Feinmechaniker/AVRCPM/README

Aeternum
CP/M - System auf Basis eines AVR

verwendetets System ZSDOS
