Feinmechaniker/AVRCPM/System/CPM/readme.txt

Terminaleinstellungen
-------------------------------
Terminaltype: VT100
Baudrate:	115200

Diskimage
--------------
A: CP/M Bootdisk + Tools
B: Turbo Pascal + I2C Tools
C: C-Compiler
D: ZSDOS Komplett
E: Wordstar
F: Turbo Pascal Installation
G: Quellen für ZSDOS System
