Feinmechaniker/AVRCPM/Case/Case.jpg

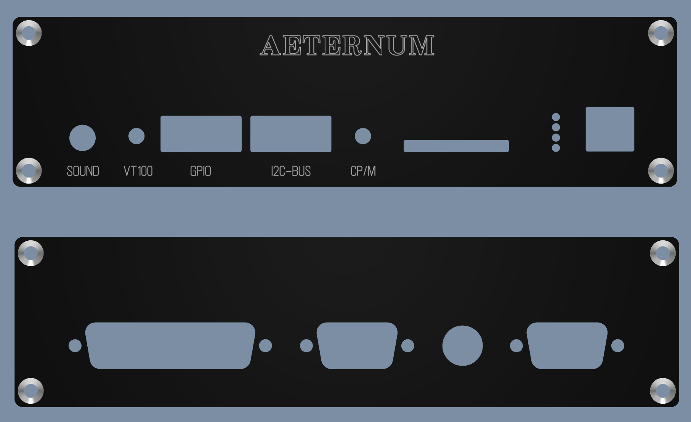
Case/Case.jpg
