Feinmechaniker/AVRCPM/Case/Hinten.dxf

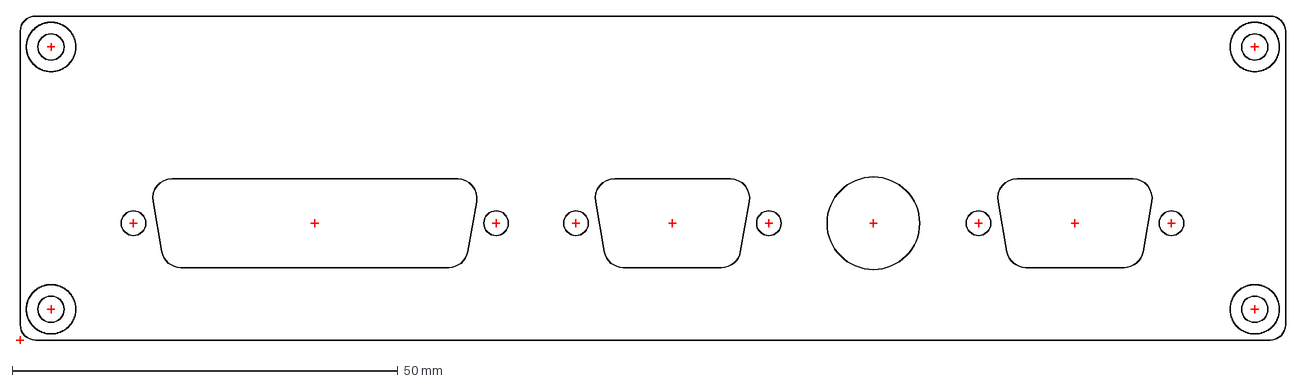
[picture p12: CAD file, 2019-03-15]
Case/Hinten.dxf
164.5 x 42.5 mm
