Feinmechaniker/AVRCPM/Case/Unten.dxf

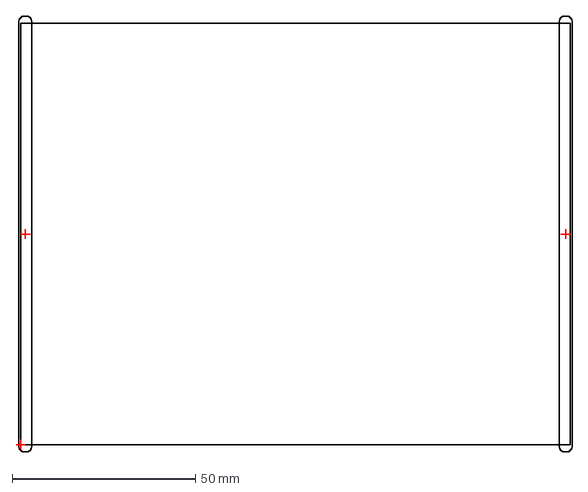
[picture p13: CAD file, 2019-03-07]
Case/Unten.dxf
151.8 x 119.0 mm
