Feinmechaniker/AVRCPM/Case/Oben.dxf

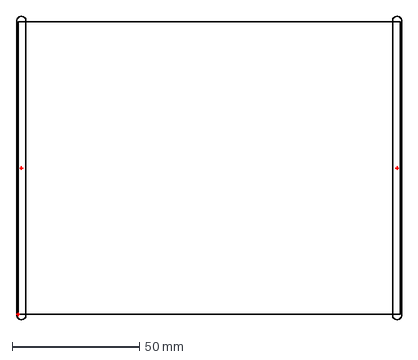
[picture p14: CAD file, 2019-03-07]
Case/Oben.dxf
151.2 x 119.0 mm
