Feinmechaniker/AVRCPM/(list of files, cad)

Other CAD files:
avr/avrcpm.obj
avr_7/avrcpm/default/avrcpm.obj
