Feinmechaniker/AVRCPM/Doku/Errata_V1_0.pdf

Errata Aeternum V1.x

Nr. | Inhalt | geändert | Vers.
1 Bestückungsdruck SW1 und SW2 ON/OFF vertauscht | DIP Switch richtig einbauen! | Board | 1.1
2 | Padgröße von C17 und C18 auf 0603 geändert | Board | 1.2
3 | Pad von C21 auf THT geändert und an IC U1 verlegt | Board | 1.2
4 | C12 von RTC an Vcc der RTC | Schaltung/Board | 1.3
5 | Q5 Package HC49U | Board | 1.3
6 | X2, X5 Befestigungspads mit Durchkontaktierung | Board | 1.3
