Feinmechaniker/AVRCPM/Doku/overview.pdf

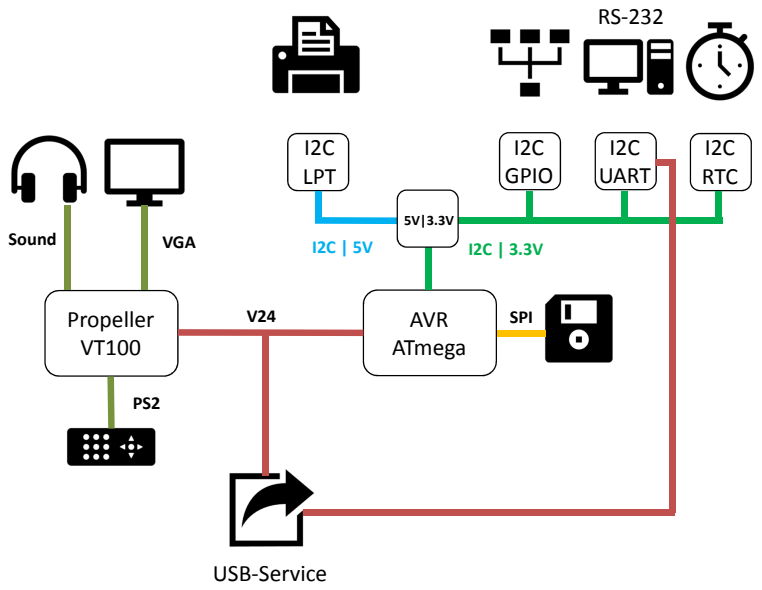
[picture p15: page 1]
Propeller VT100; USB-Service; AVR ATmega; I2C UART; I2C LPT; I2C RTC; I2C GPIO; SPI; Sound; VGA
