Feinmechaniker/AVRCPM/Sheet/Doc/Aeternum_V1_3_Sheet.pdf

8Q | 12 7Q | 13 6Q | 14 5Q | 15 4Q | 16 3Q | 17 2Q | 18 1Q | 19

A

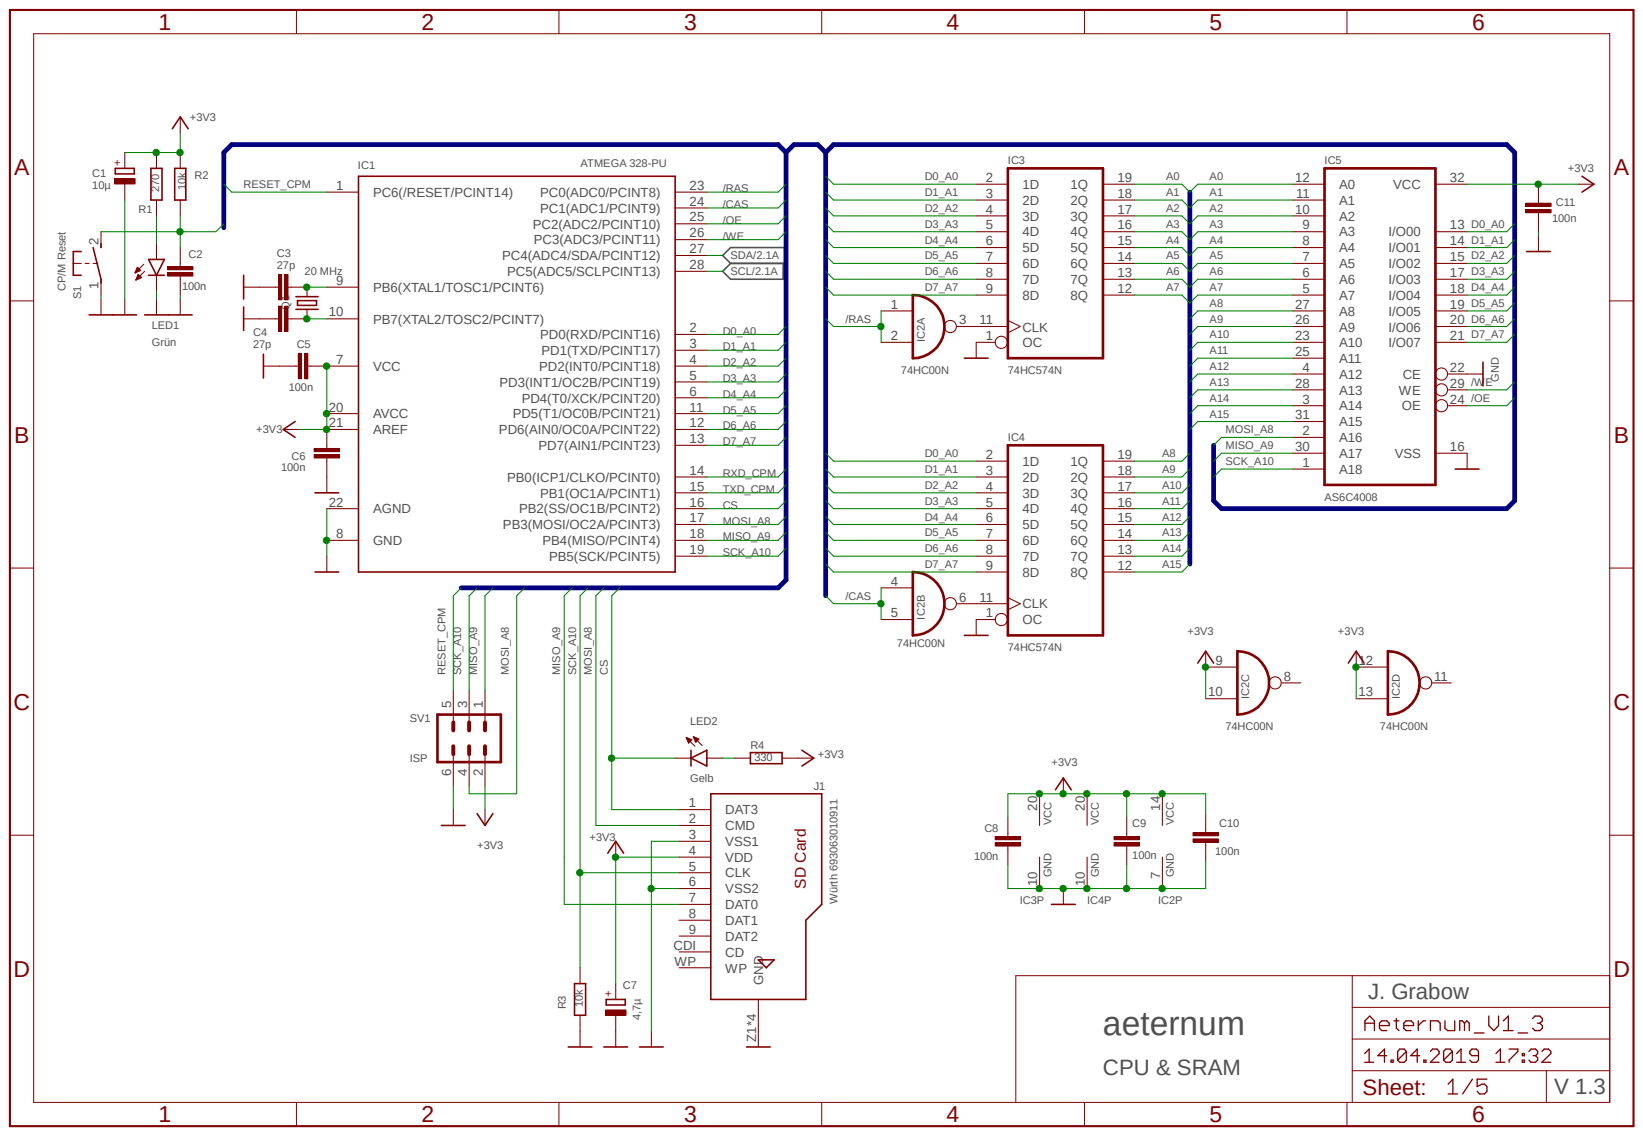
[picture p16: page 1]

A

A

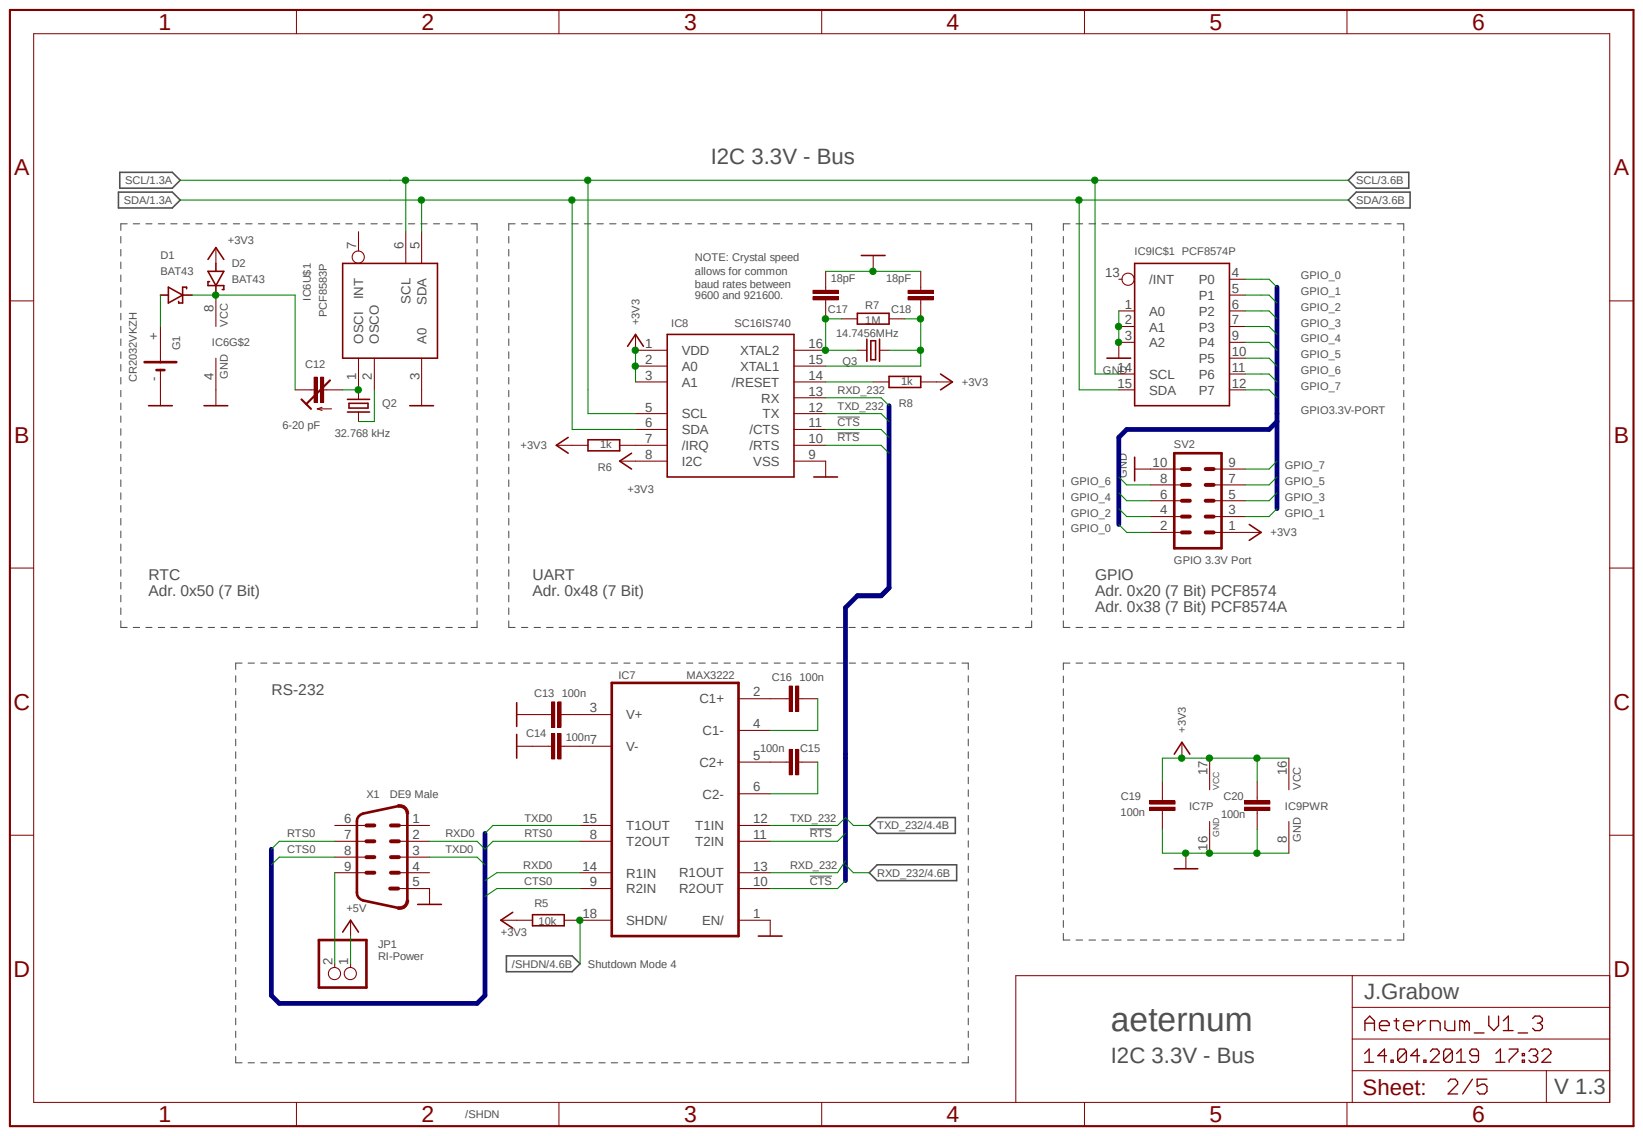
[picture p17: page 2]

I2C 3.3V - Bus

## CENTRONICS

A

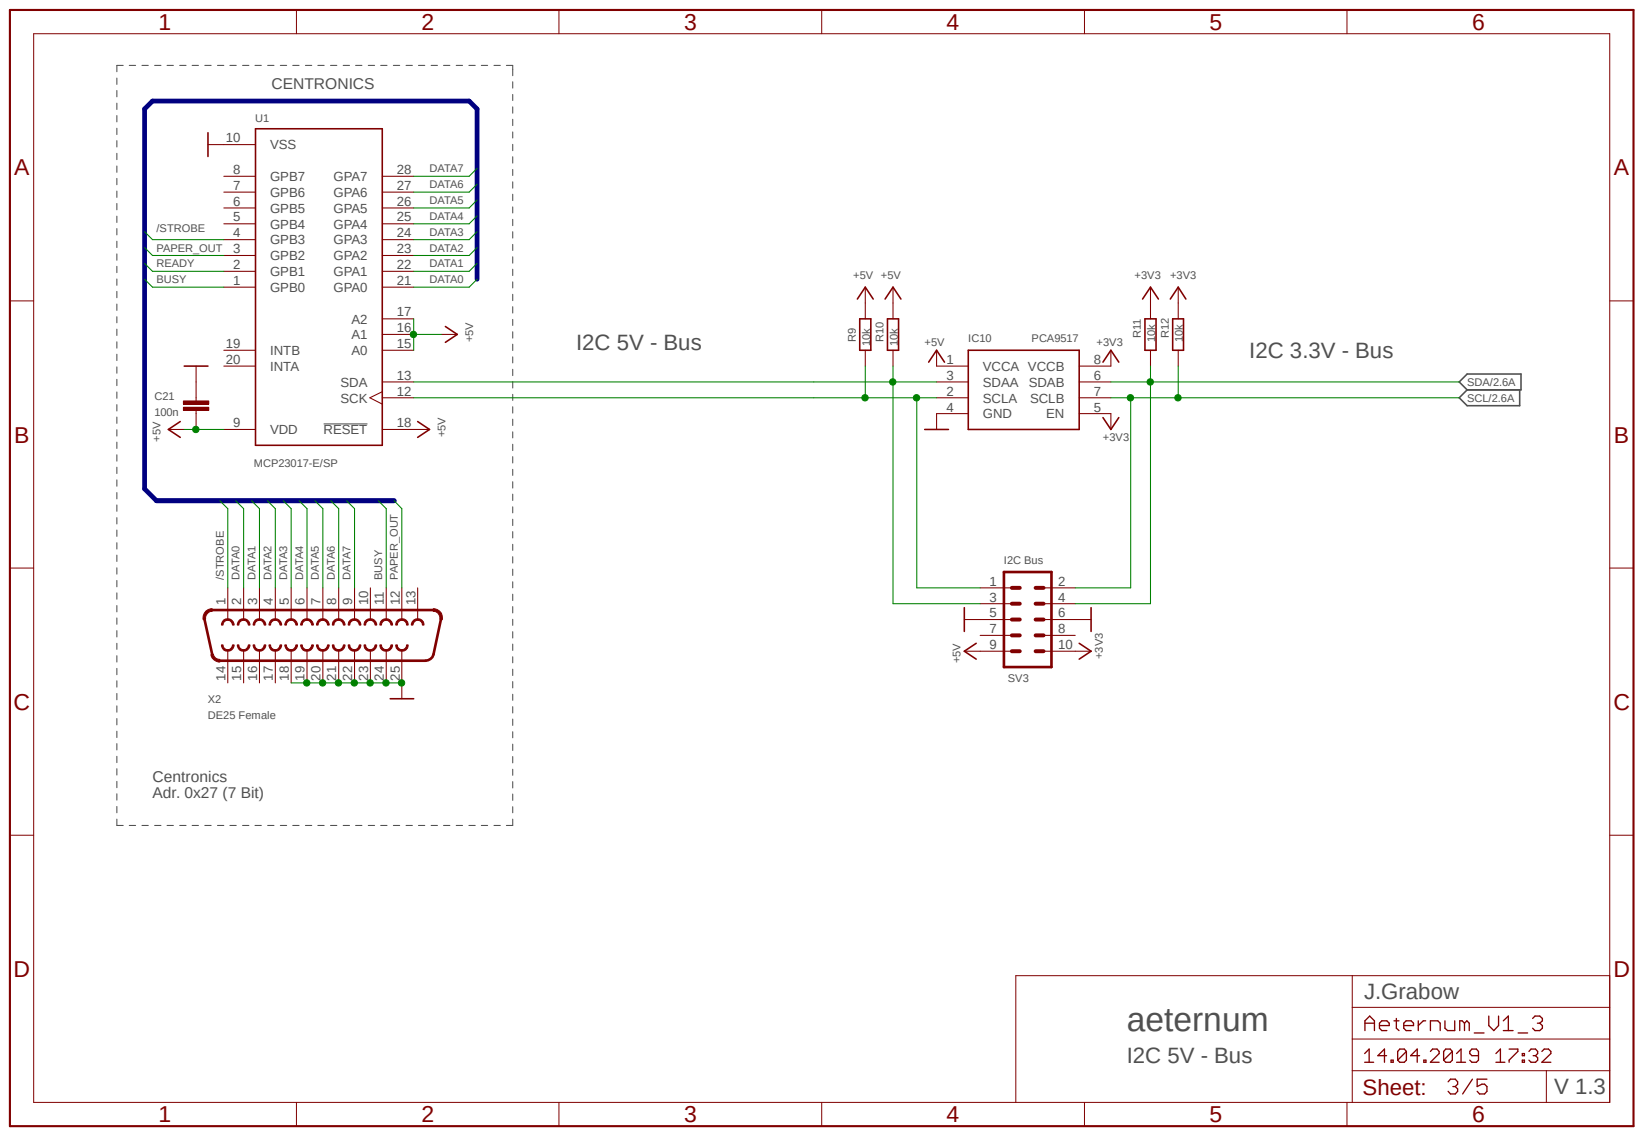
[picture p18: page 3]
I2C 5V - Bus; aeternum; J.Grabow; I2C 3.3V - Bus; Adr. 0x27 (7 Bit); Centronics; PCA9517; MCP23017-E/SP; DE25 Female; I2C Bus; SDAA 3 SCLA 2; VCCB; 8 VCCA 1; SDAB; SCLB; 5 GND 4; VDD 9; VSS 10; SCK; 12 SDA; RESET; INTA 20; INTB 19; GPA0; 21 GPA1; 22 GPA2; 23 GPA3; 24 GPA4; 25 GPA5; 26 GPA6; 27 GPA7; 28 GPB0 1; GPB1 2; GPB2 3; GPB3 4; GPB4 5; GPB5 6; GPB6 7; GPB7 8; SDA/2.6A SCL/2.6A; DATA0; DATA1; DATA2; DATA3; DATA4; DATA5; DATA6; DATA7; BUSY; READY; PAPER_OUT; /STROBE; Sheet:

A

A

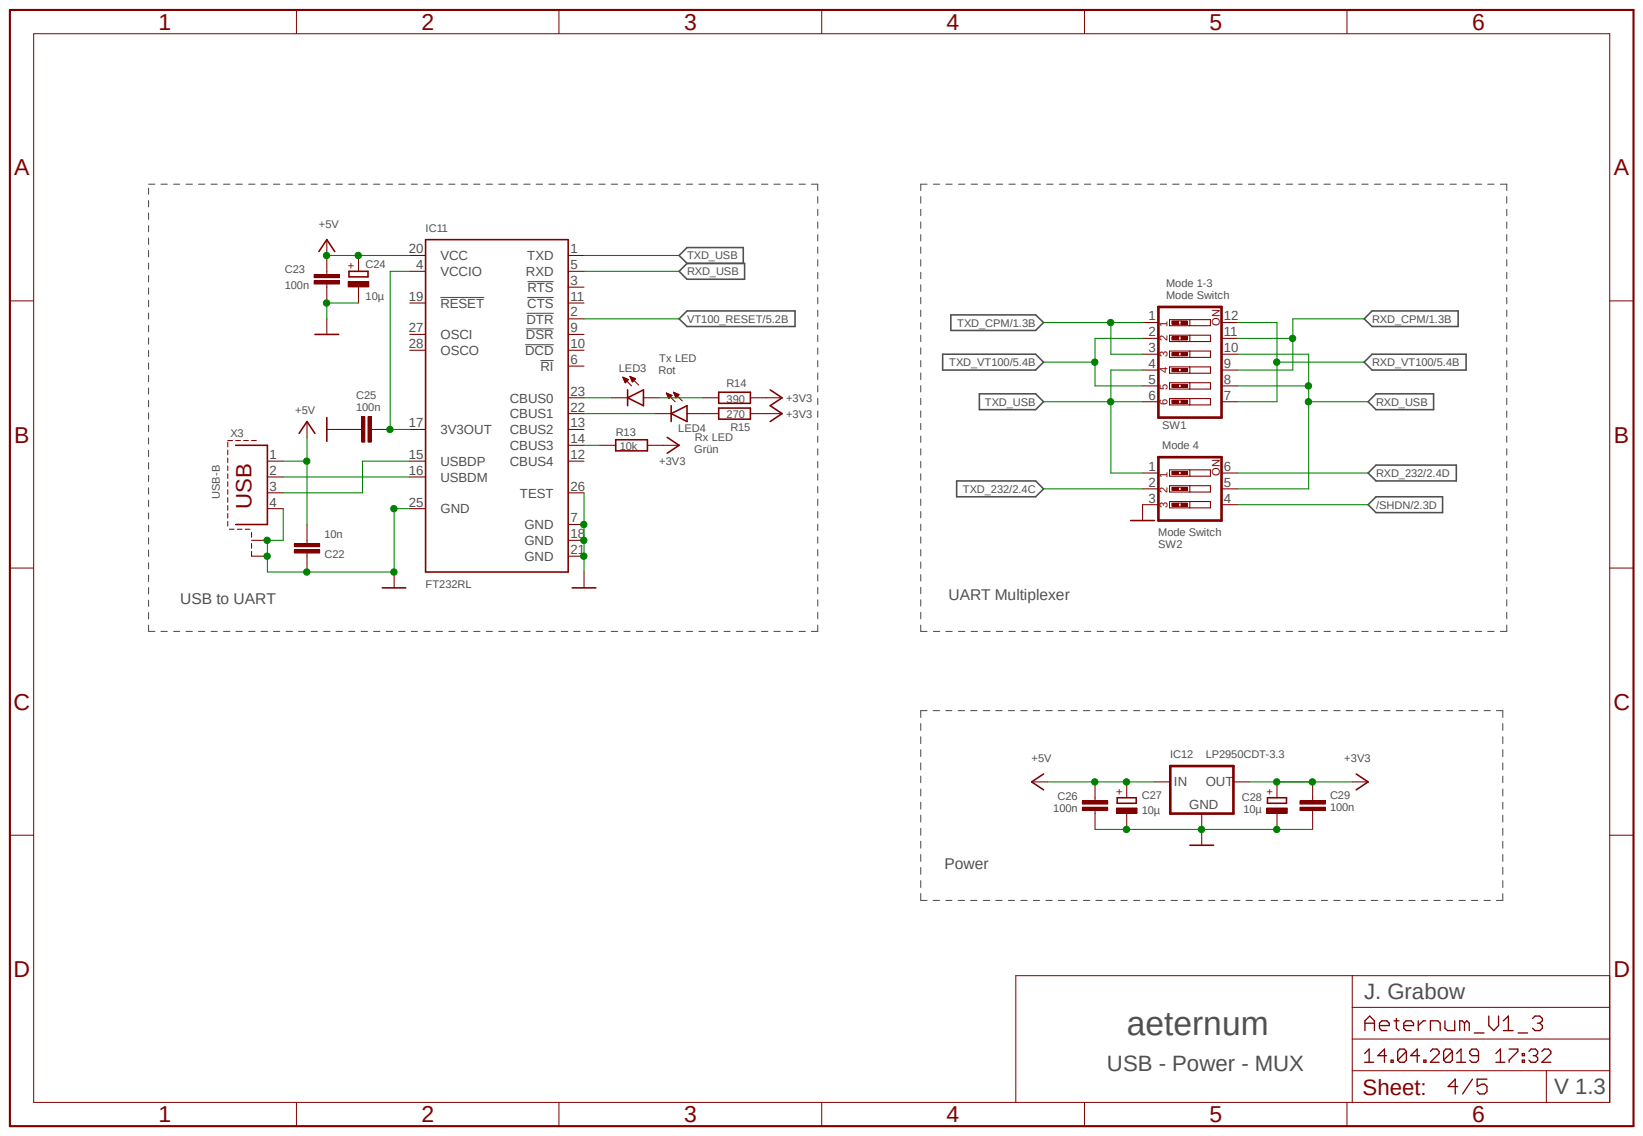
[picture p19: page 4]

A

A

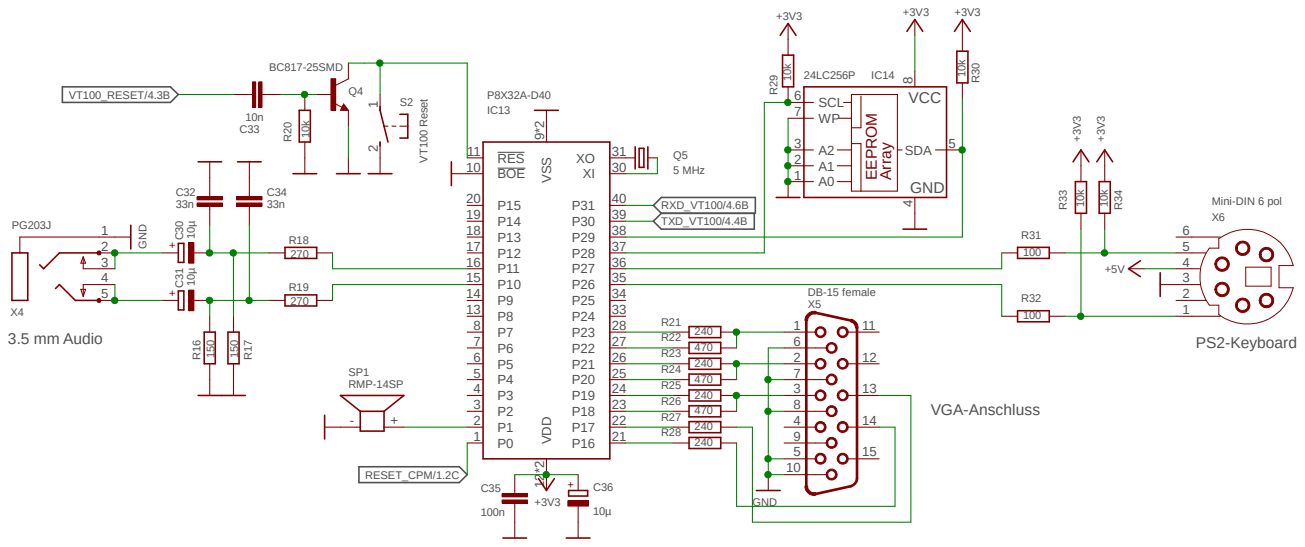
[picture p20: page 5]
