Feinmechaniker/AVRCPM/Case/Hinten.pdf

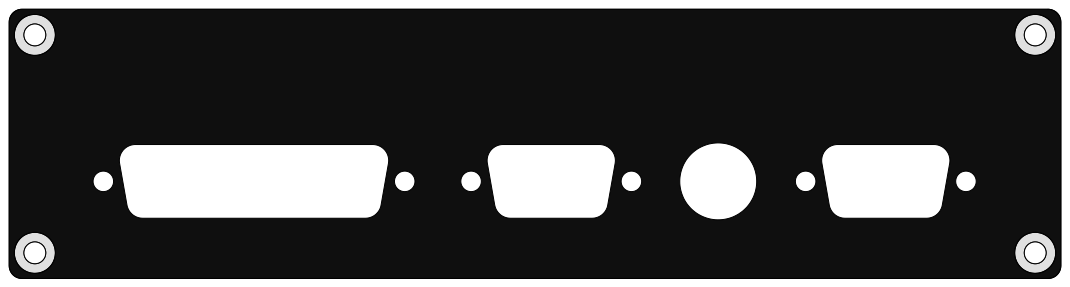
[picture p21: page 1]
