Feinmechaniker/AVRCPM/Sheet/Doc/Aeternum_V1_3_Bottom.pdf

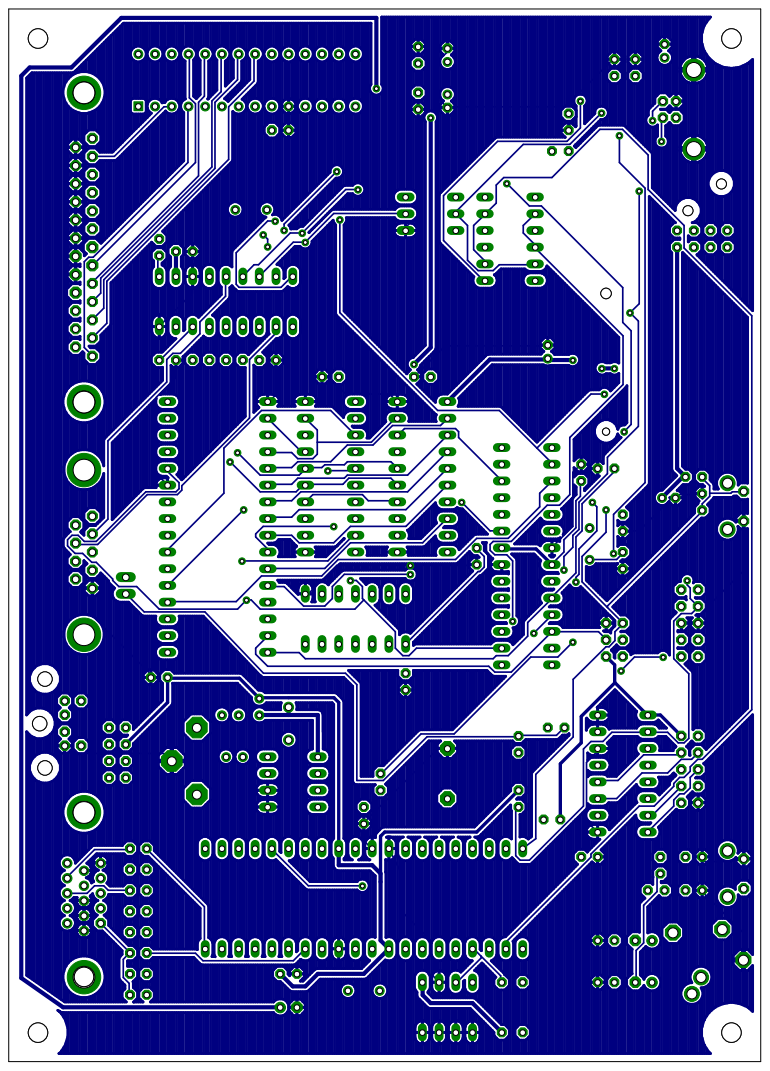
[picture p22: page 1]
