Feinmechaniker/AVRCPM/Sheet/Doc/Aeternum_V1_3_Doku.pdf

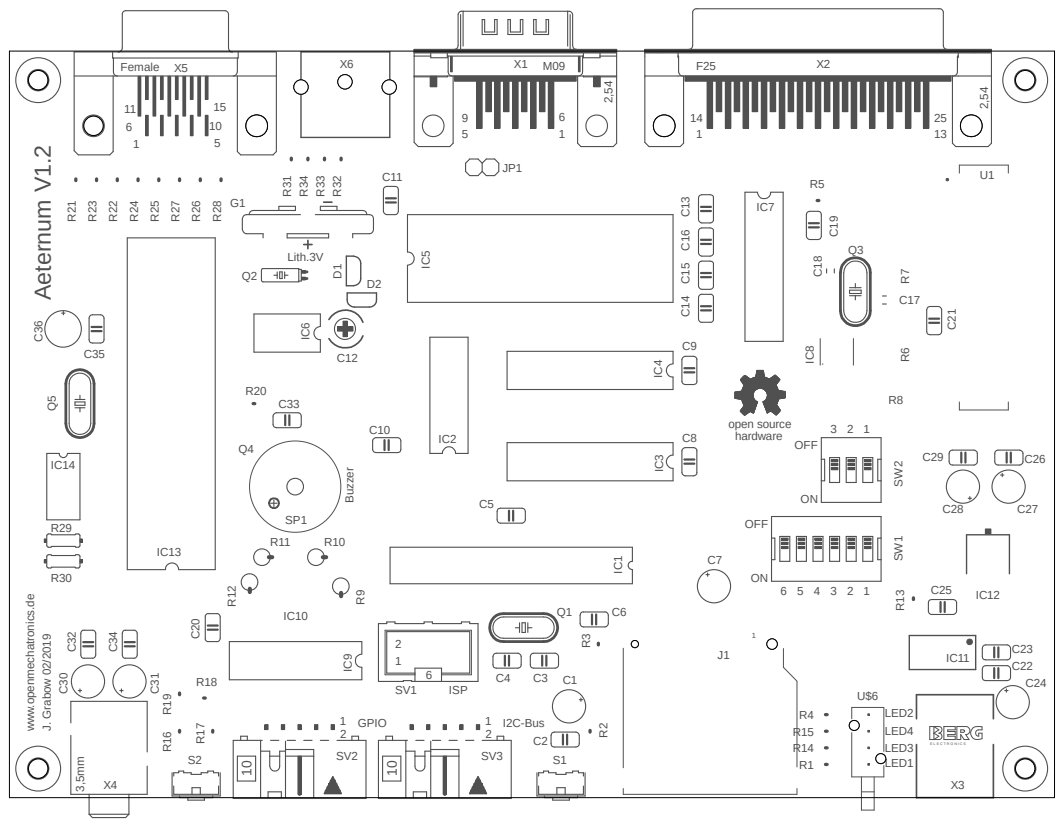
[picture p23: page 1]
