Feinmechaniker/AVRCPM/Sheet/Doc/Aeternum_V1_3_Top.pdf

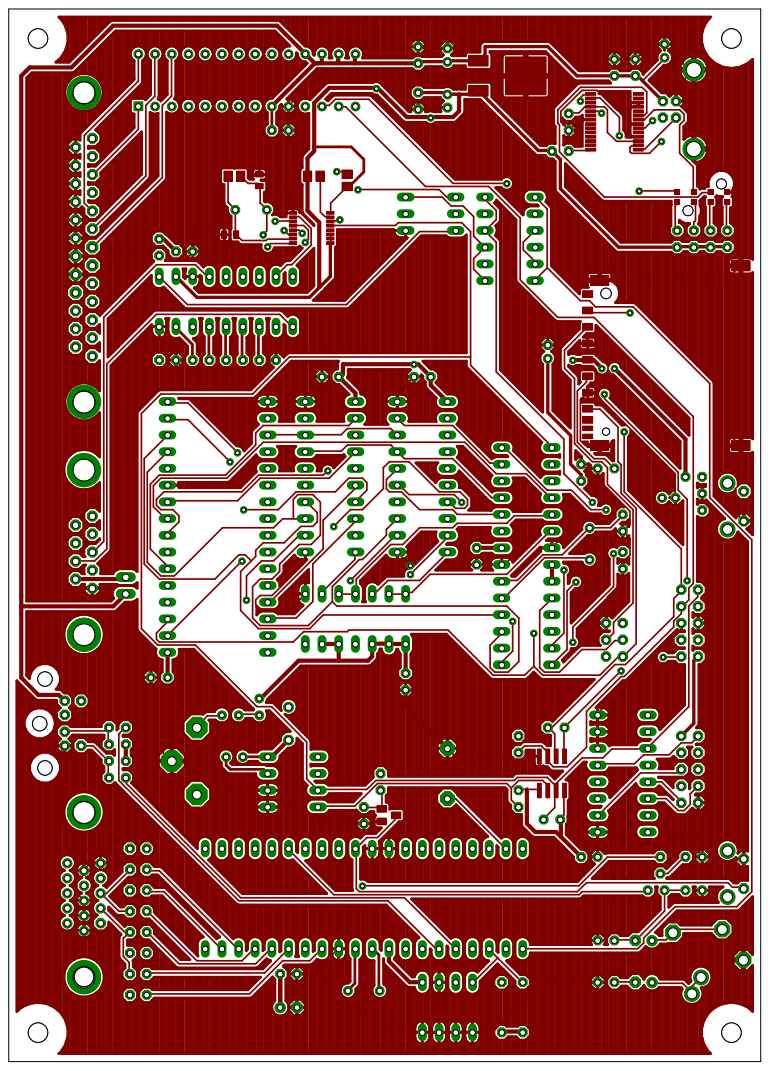
[picture p24: page 1]
