Feinmechaniker/AVRCPM/Sheet/Doc/Aeternum_V1_2_Dokupdf.pdf

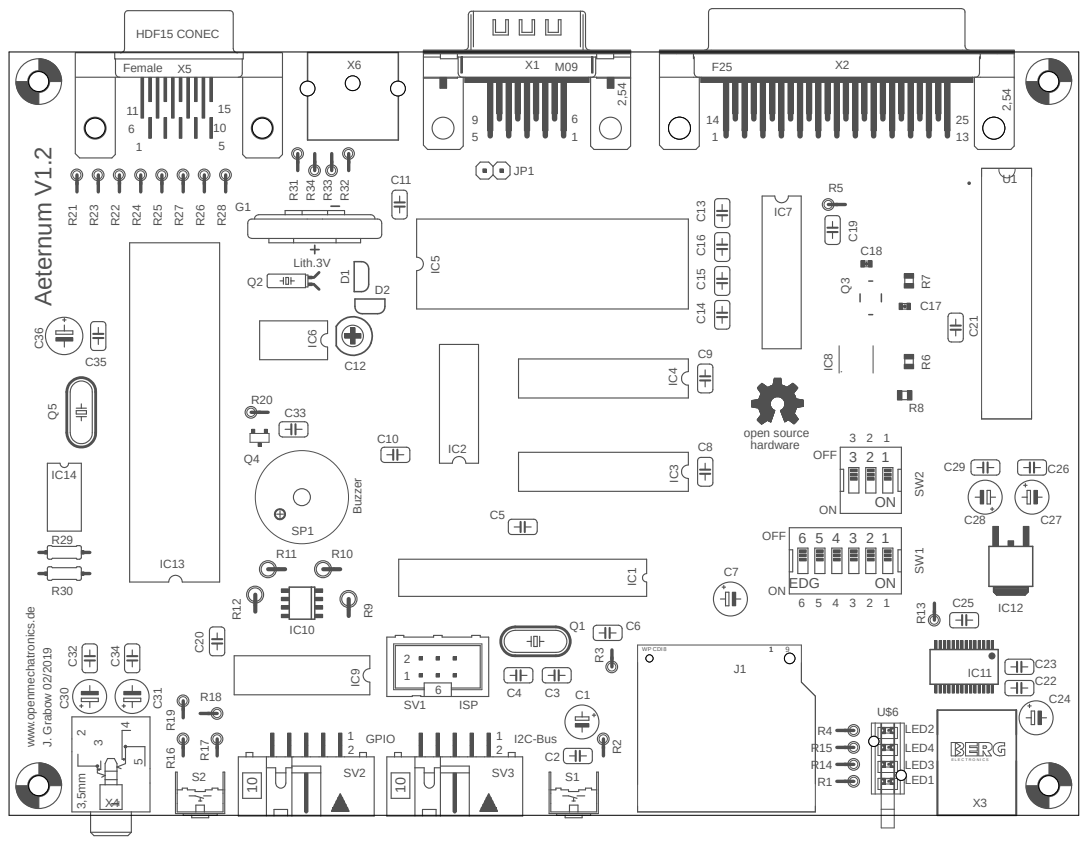
[picture p25: page 1]
