Feinmechaniker/AVRCPM/Sheet/Doc/Aeternum_V1_0_Bottom.pdf

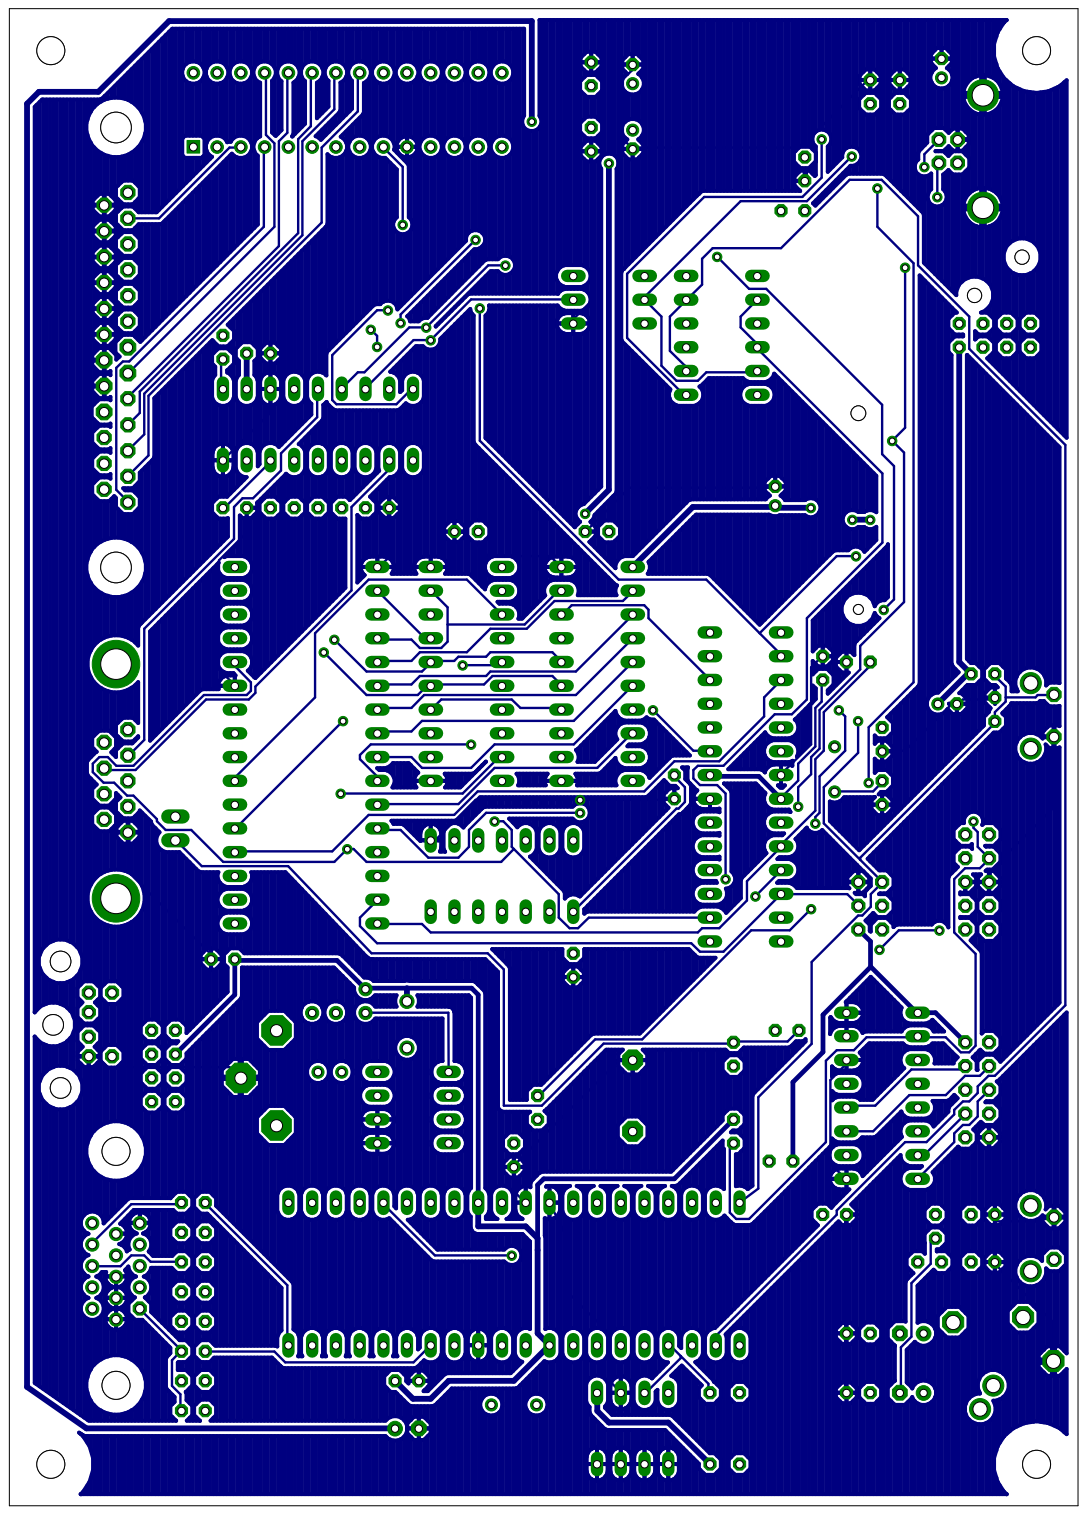
[picture p34: page 1]
