Feinmechaniker/AVRCPM/Sheet/Doc/Aeternum_V1_0_Doku.pdf

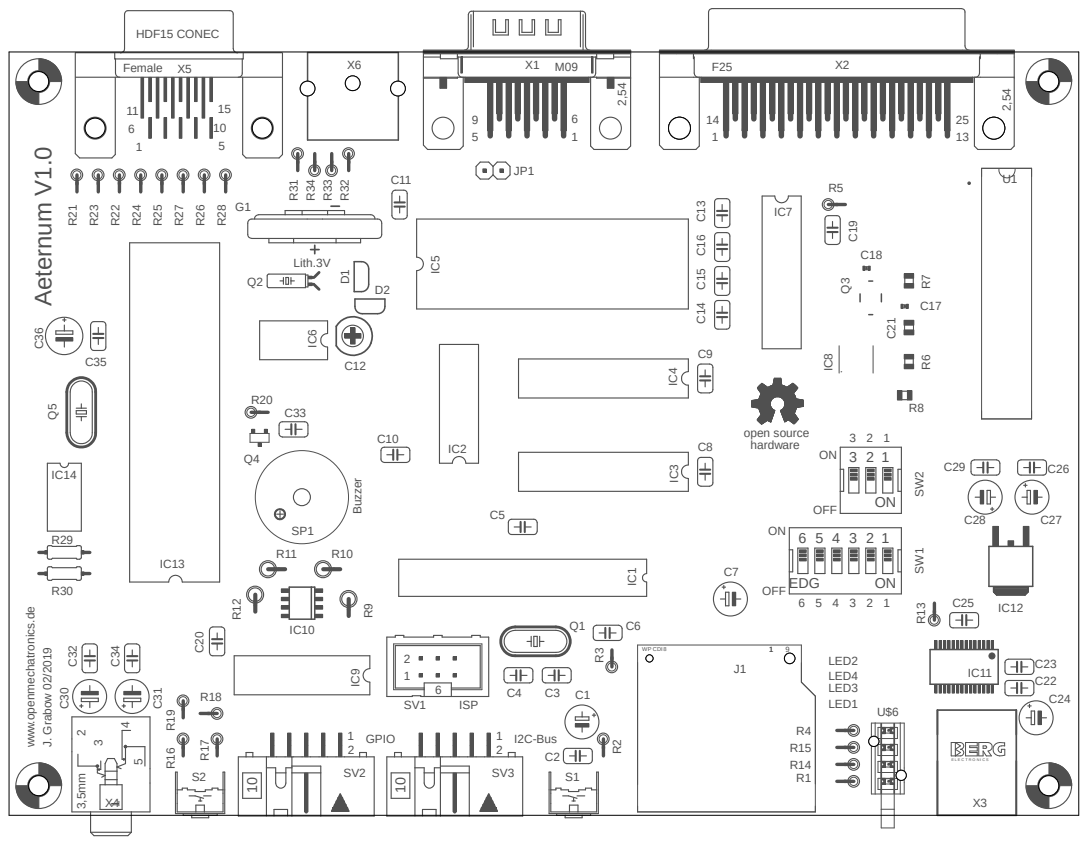
[picture p35: page 1]
