Feinmechaniker/AVRCPM/Sheet/Doc/Aeternum_V1_0_Top.pdf

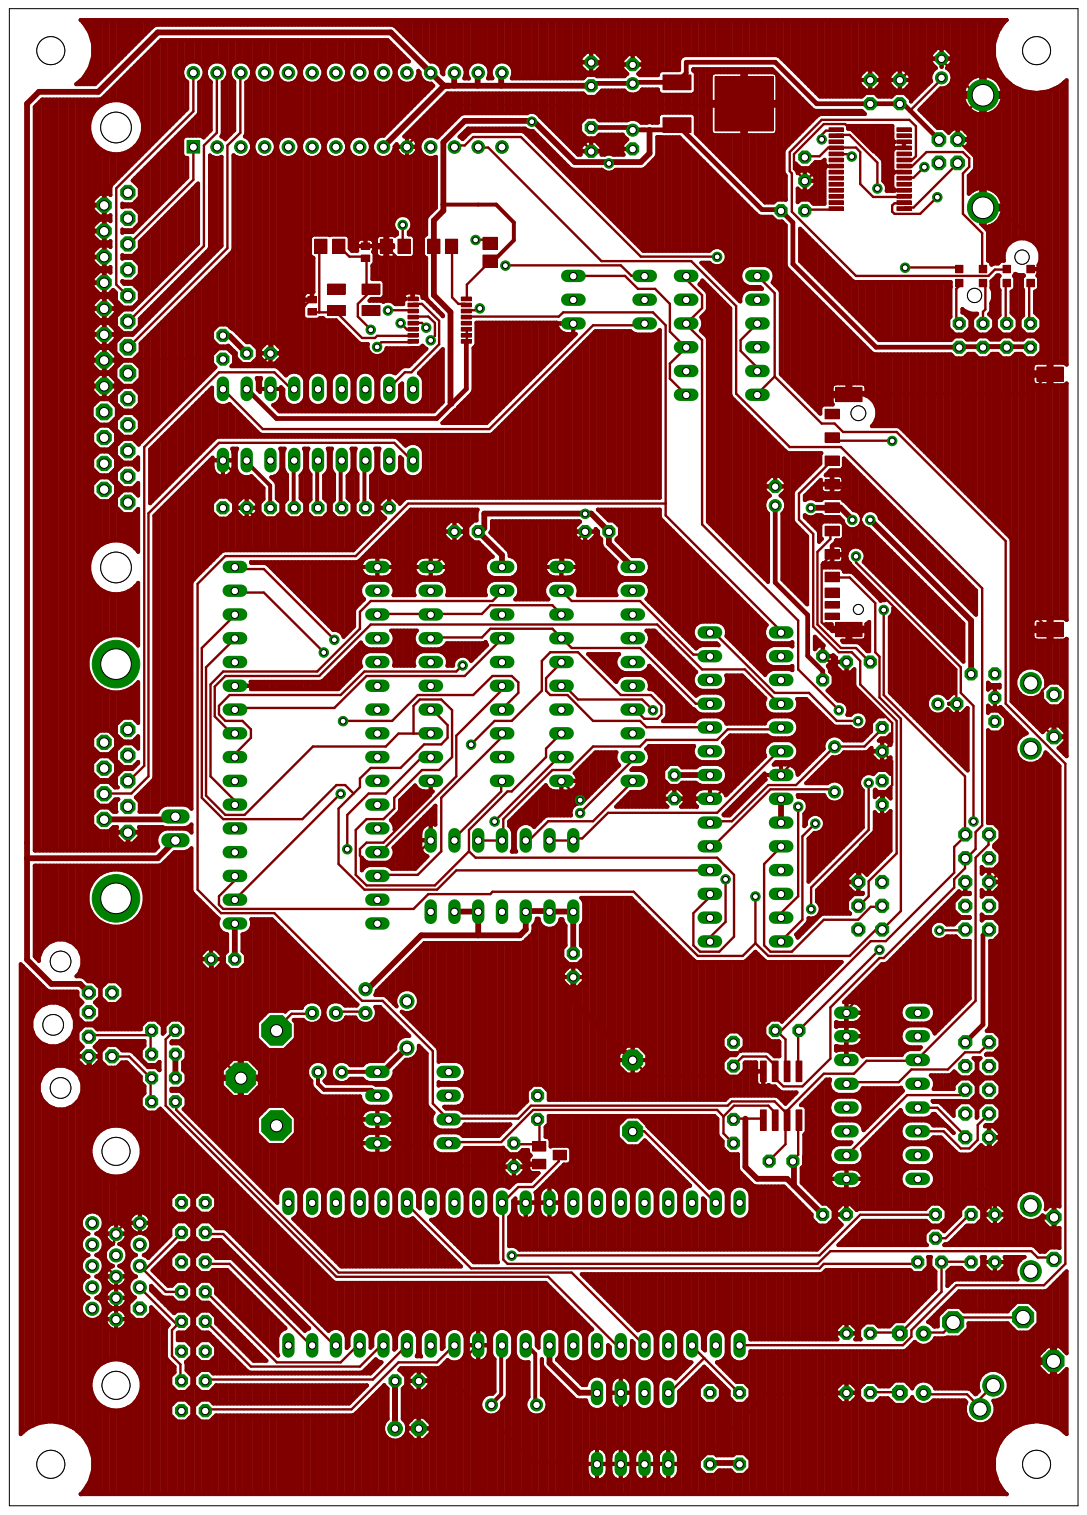
[picture p36: page 1]
