Feinmechaniker/AVRCPM/Sheet/Doc/Aeternum_V1_2_Bottom.pdf

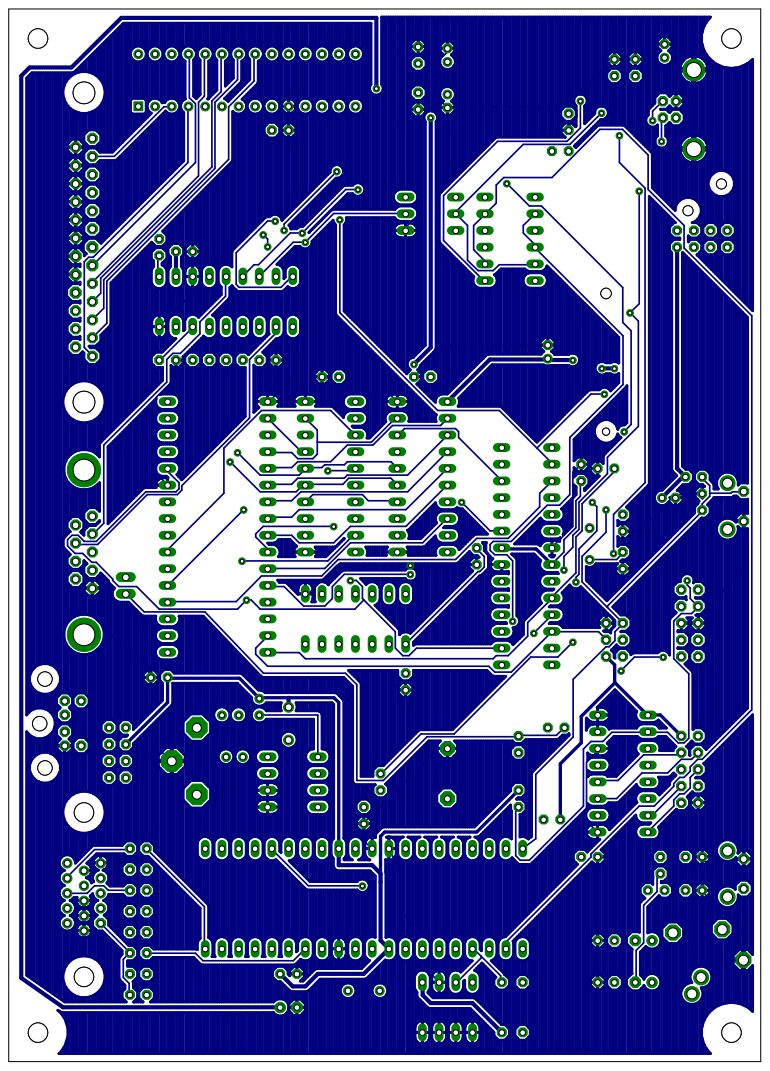
[picture p37: page 1]
