Feinmechaniker/AVRCPM/Sheet/Doc/Aeternum_V1_2_Top.pdf

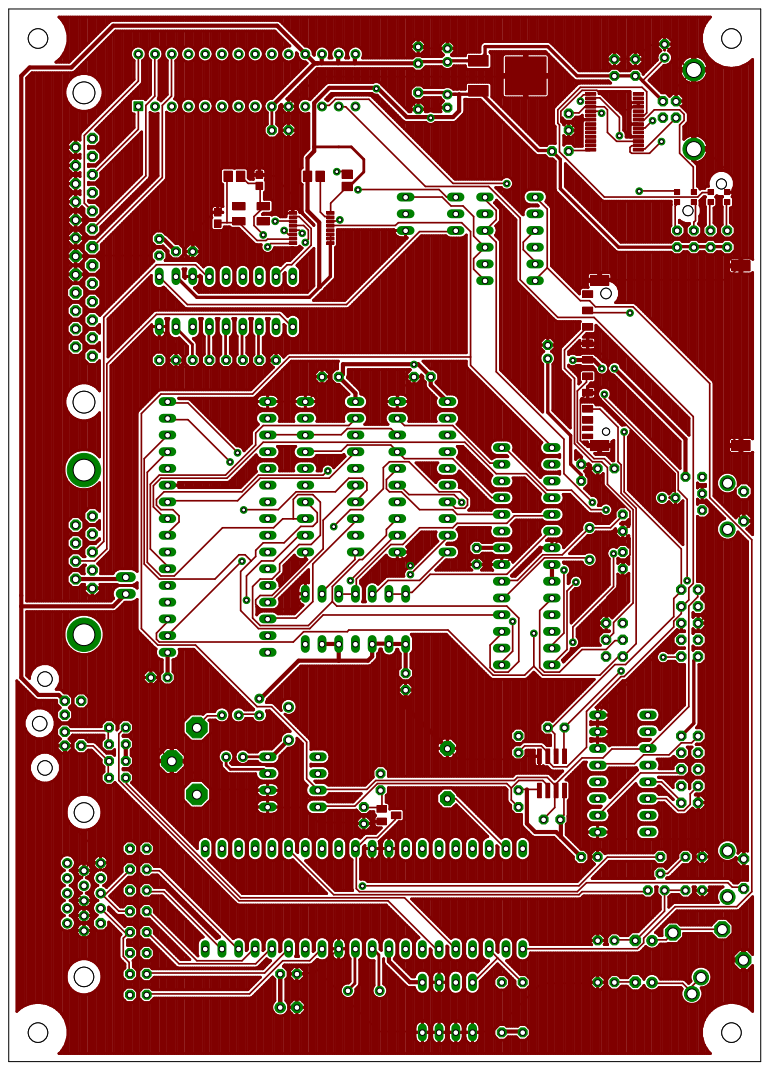
[picture p38: page 1]
