Feinmechaniker/AVRCPM/Sheet/Eagle/Aeternum_V1_2.brd

## EAGLE design Sheet/Eagle/Aeternum_V1_2.brd (2019-03-07)

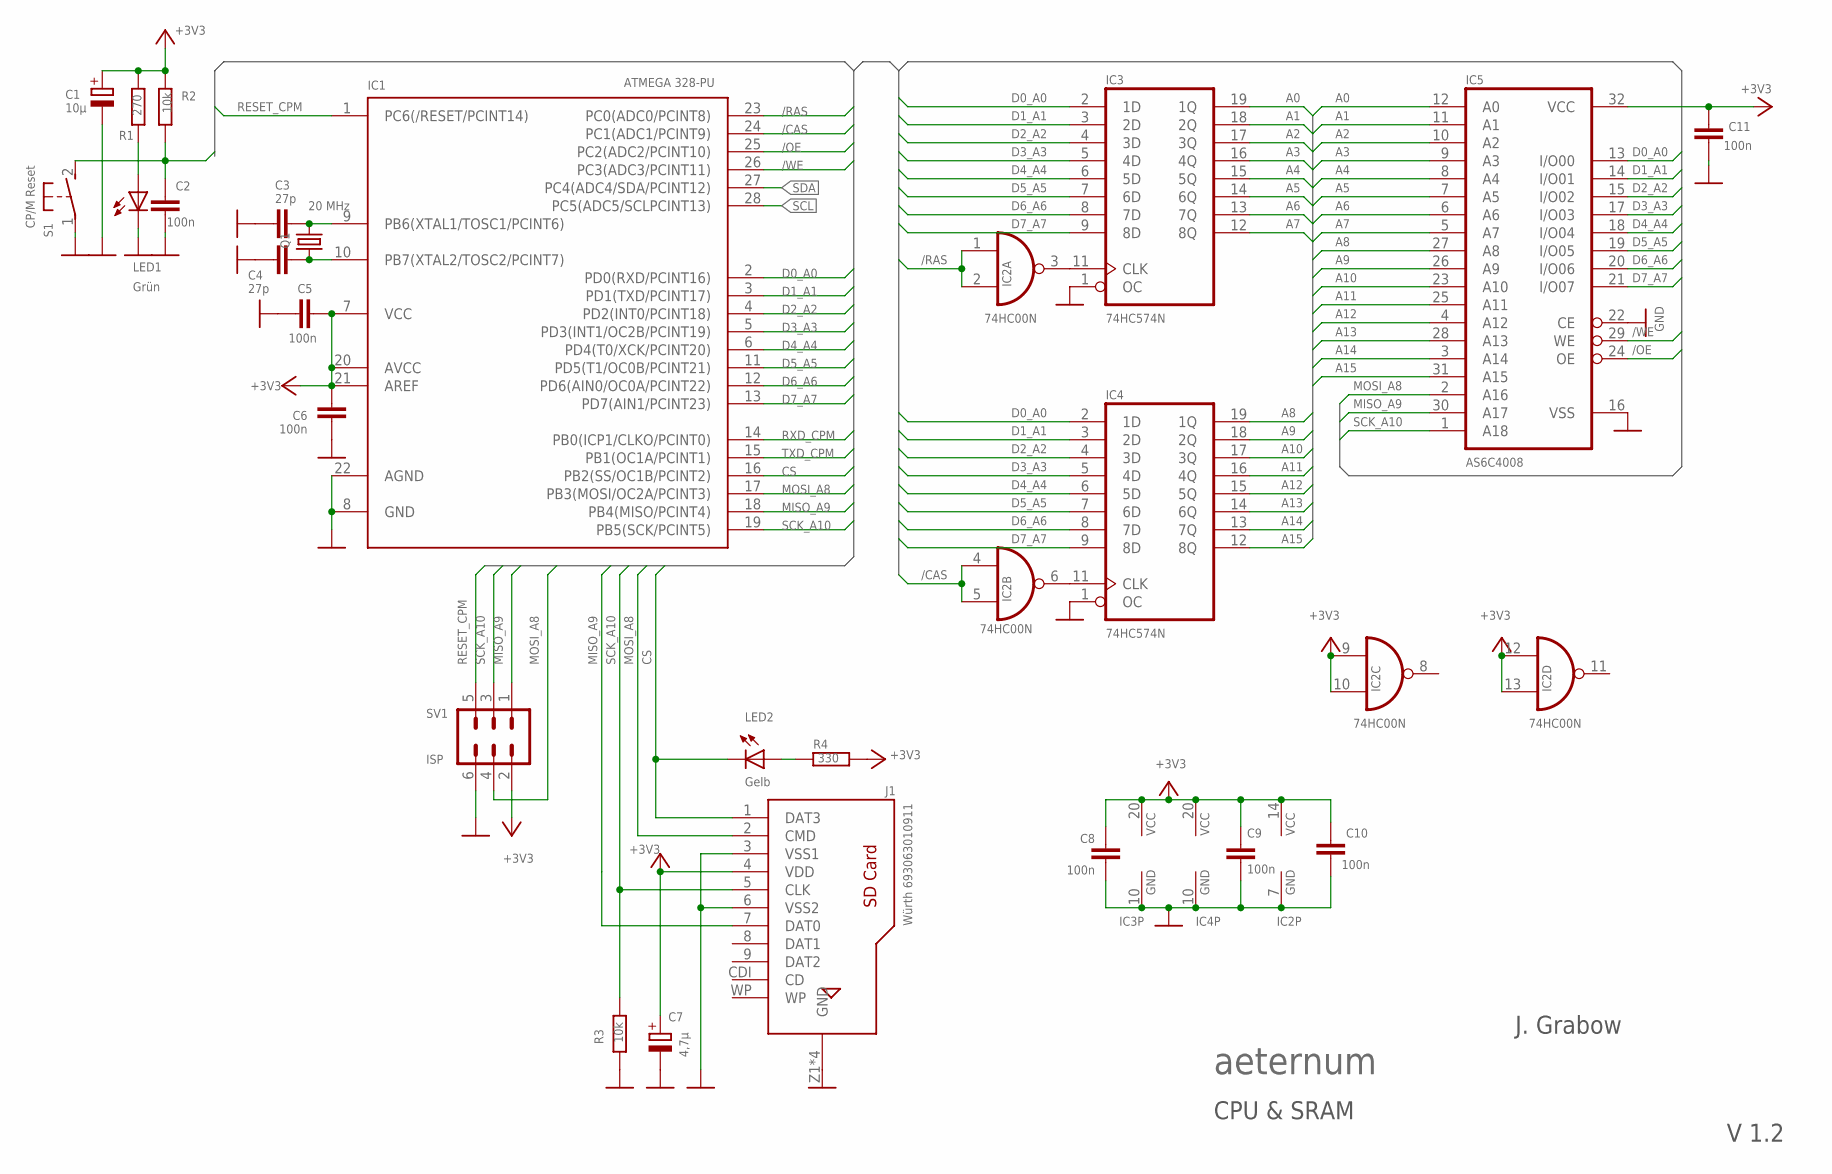
[picture p39: schematic Aeternum_V1_2.sch, sheet 1]

Parts:
C1: 10µ; E2-5
C2, C5, C6, C8, C9, C10, C11: 100n; C025-024X044
C3, C4: 27p; C025-024X044
C7: 4,7µ; E2-5
IC1: ATMEGA 328-PU; DIL28-3
IC2: 74HC00N; DIL14
IC3, IC4: 74HC574N; DIL20
IC5: AS6C4008; DIL32
J1: Würth 693063010911; 693063010911
LED1: Grün; CHIPLED_0603
LED2: Gelb; CHIPLED_0603
Q1: 20 MHz; HC49/S
R1: 270; 0204V
R2, R3: 10k; 0204V
R4: 330; 0204V
S1: CP/M Reset; B3F-31XX
SV1: ISP; ML6

Connections:
+3V3: C1.+, C5.1, C6.2, C7.+, C8.1, C9.1, C10.1, C11.1, IC1.7 (VCC), IC1.20 (AVCC), IC1.21 (AREF), IC2.9 (I0), IC2.10 (I1), IC2.12 (I0), IC2.13 (I1), IC2.14 (VCC), IC3.20 (VCC), IC4.20 (VCC), IC5.32 (VCC), J1.4 (VDD), R1.2, R2.1, R4.2, SV1.2; also elsewhere on the board
/CAS: IC1.24 (PC1(ADC1/PCINT9)), IC2.4 (I0), IC2.5 (I1)
/OE: IC1.25 (PC2(ADC2/PCINT10)), IC5.24 (OE)
/RAS: IC1.23 (PC0(ADC0/PCINT8)), IC2.1 (I0), IC2.2 (I1)
/WE: IC1.26 (PC3(ADC3/PCINT11)), IC5.29 (WE)
A0: IC3.19 (1Q), IC5.12 (A0)
A1: IC3.18 (2Q), IC5.11 (A1)
A2: IC3.17 (3Q), IC5.10 (A2)
A3: IC3.16 (4Q), IC5.9 (A3)
A4: IC3.15 (5Q), IC5.8 (A4)
A5: IC3.14 (6Q), IC5.7 (A5)
A6: IC3.13 (7Q), IC5.6 (A6)
A7: IC3.12 (8Q), IC5.5 (A7)
A8: IC4.19 (1Q), IC5.27 (A8)
A9: IC4.18 (2Q), IC5.26 (A9)
A10: IC4.17 (3Q), IC5.23 (A10)
A11: IC4.16 (4Q), IC5.25 (A11)
A12: IC4.15 (5Q), IC5.4 (A12)
A13: IC4.14 (6Q), IC5.28 (A13)
A14: IC4.13 (7Q), IC5.3 (A14)
A15: IC4.12 (8Q), IC5.31 (A15)
CS: IC1.16 (PB2(SS/OC1B/PCINT2)), J1.1 (DAT3), LED2.C
D0_A0: IC1.2 (PD0(RXD/PCINT16)), IC3.2 (1D), IC4.2 (1D), IC5.13 (I/O00)
D1_A1: IC1.3 (PD1(TXD/PCINT17)), IC3.3 (2D), IC4.3 (2D), IC5.14 (I/O01)
D2_A2: IC1.4 (PD2(INT0/PCINT18)), IC3.4 (3D), IC4.4 (3D), IC5.15 (I/O02)
D3_A3: IC1.5 (PD3(INT1/OC2B/PCINT19)), IC3.5 (4D), IC4.5 (4D), IC5.17 (I/O03)
D4_A4: IC1.6 (PD4(T0/XCK/PCINT20)), IC3.6 (5D), IC4.6 (5D), IC5.18 (I/O04)
D5_A5: IC1.11 (PD5(T1/OC0B/PCINT21)), IC3.7 (6D), IC4.7 (6D), IC5.19 (I/O05)
D6_A6: IC1.12 (PD6(AIN0/OC0A/PCINT22)), IC3.8 (7D), IC4.8 (7D), IC5.20 (I/O06)
D7_A7: IC1.13 (PD7(AIN1/PCINT23)), IC3.9 (8D), IC4.9 (8D), IC5.21 (I/O07)
GND: C1.-, C2.1, C3.2, C4.2, C5.2, C6.1, C7.-, C8.2, C9.2, C10.2, C11.2, IC1.8 (GND), IC1.22 (AGND), IC2.7 (GND), IC3.1 (OC), IC3.10 (GND), IC4.1 (OC), IC4.10 (GND), IC5.16 (VSS), IC5.22 (CE), J1.3 (VSS1), J1.6 (VSS2), J1.Z1 (GND), J1.Z2 (GND), J1.Z3 (GND), J1.Z4 (GND), LED1.C, R3.2, S1.1, SV1.6; also elsewhere on the board
MISO_A9: IC1.18 (PB4(MISO/PCINT4)), IC5.30 (A17), J1.7 (DAT0), SV1.1
MOSI_A8: IC1.17 (PB3(MOSI/OC2A/PCINT3)), IC5.2 (A16), J1.2 (CMD), SV1.4
unnamed: C4.1, IC1.10 (PB7(XTAL2/TOSC2/PCINT7)), Q1.1
unnamed: IC2.3 (O), IC3.11 (CLK)
unnamed: LED1.A, R1.1
unnamed: LED2.A, R4.1
unnamed: C3.1, IC1.9 (PB6(XTAL1/TOSC1/PCINT6)), Q1.2
unnamed: IC2.6 (O), IC4.11 (CLK)
RESET_CPM: C2.2, IC1.1 (PC6(/RESET/PCINT14)), R2.2, S1.2 (S), SV1.5; also elsewhere on the board
RXD_CPM: IC1.14 (PB0(ICP1/CLKO/PCINT0)); also elsewhere on the board
SCK_A10: IC1.19 (PB5(SCK/PCINT5)), IC5.1 (A18), J1.5 (CLK), R3.1, SV1.3
SCL: IC1.28 (PC5(ADC5/SCLPCINT13)); also elsewhere on the board
SDA: IC1.27 (PC4(ADC4/SDA/PCINT12)); also elsewhere on the board
TXD_CPM: IC1.15 (PB1(OC1A/PCINT1)); also elsewhere on the board

Notes on the sheet:
aeternum
V 1.2
J. Grabow
CPU & SRAM

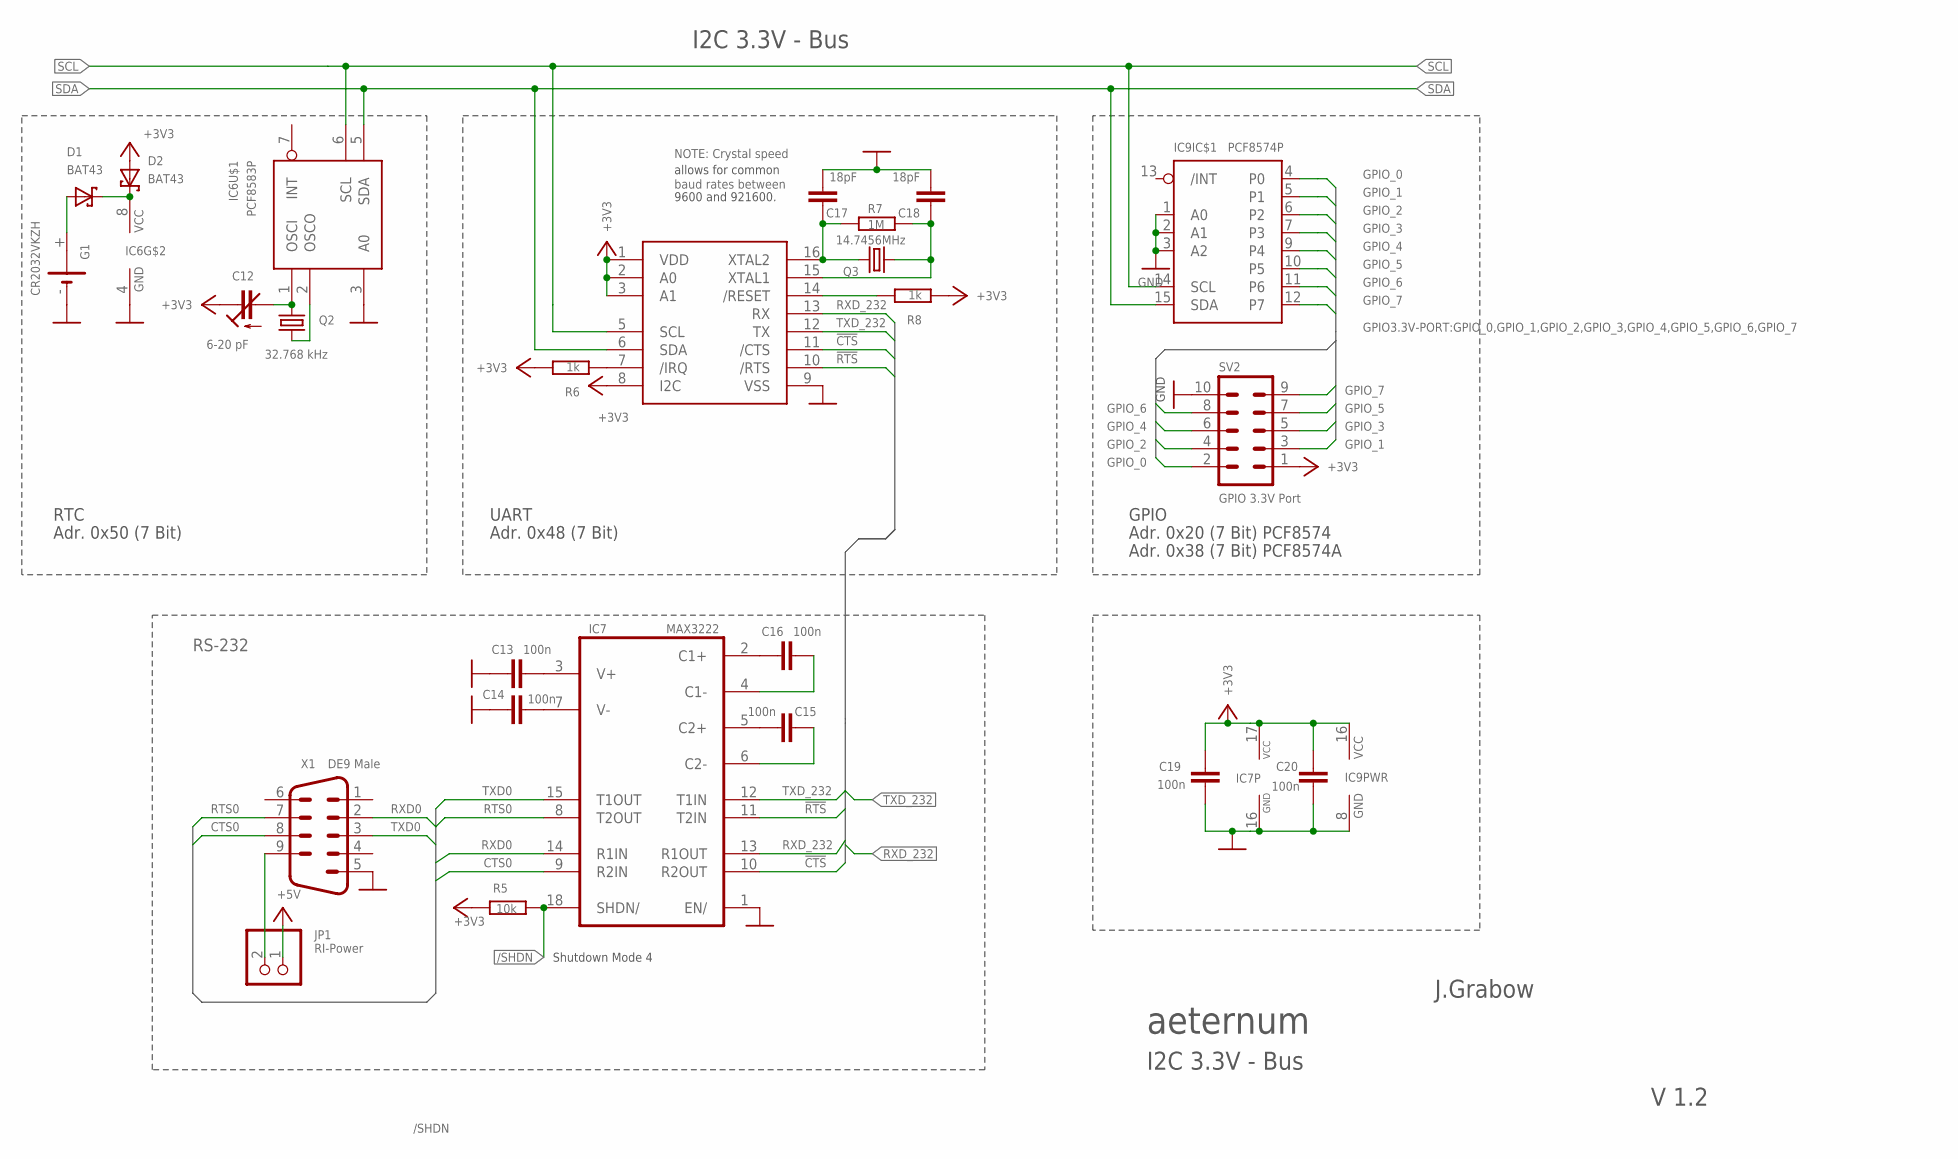
[picture p40: schematic Aeternum_V1_2.sch, sheet 2]

Parts:
C12: 6-20 pF; CTRIMTZ03
C13, C14, C15, C16, C19, C20: 100n; C025-024X044
C17, C18: 18pF; 0603-CAP
D1, D2: BAT43; E2LINE
G1: CR2032VKZH; KZH20PCB-V
IC6: PCF8583P; DIL08
IC7: MAX3222; DIL18
IC8: SC16IS740; RICKK2_SC16IS740
IC9: PCF8574P; DIL16
JP1: RI-Power; 1X02
Q2: 32.768 kHz; TC26H
Q3: 14.7456MHz; CRYSTAL-SMD-5X3
R5: 10k; 0204V
R6, R8: 1k; R0805
R7: 1M; R0805
SV2: GPIO 3.3V Port; ML10L
X1: DE9 Male; M09HP

Connections:
!CTS: IC7.10 (R2OUT), IC8.11 (/CTS)
!RTS: IC7.11 (T2IN), IC8.10 (/RTS)
+3V3: C12.1 (E), C19.2, C20.2, D2.2 (A), IC7.17 (VCC), IC8.1 (VDD), IC8.2 (A0), IC8.3 (A1), IC8.8 (I2C), IC9.16 (VCC), R5.2, R6.2, R8.1, SV2.1; also elsewhere on the board
+5V: JP1.1; also elsewhere on the board
/SHDN: IC7.18 (SHDN/), R5.1; also elsewhere on the board
CTS0: IC7.9 (R2IN), X1.8
GND: C13.2, C14.2, C17.2, C18.2, C19.1, C20.1, G1.-, IC6.3 (A0), IC6.4 (GND), IC7.1 (EN/), IC7.16 (GND), IC8.9 (VSS), IC9.1 (A0), IC9.2 (A1), IC9.3 (A2), IC9.8 (GND), SV2.10, X1.5; also elsewhere on the board
GPIO_0: IC9.4 (P0), SV2.2
GPIO_1: IC9.5 (P1), SV2.3
GPIO_2: IC9.6 (P2), SV2.4
GPIO_3: IC9.7 (P3), SV2.5
GPIO_4: IC9.9 (P4), SV2.6
GPIO_5: IC9.10 (P5), SV2.7
GPIO_6: IC9.11 (P6), SV2.8
GPIO_7: IC9.12 (P7), SV2.9
unnamed: C12.2 (A), IC6.1 (OSCI), Q2.1
unnamed: IC6.2 (OSCO), Q2.2
unnamed: C17.1, IC8.16 (XTAL2), Q3.3 (2), R7.1
unnamed: C16.2, IC7.2 (C1+)
unnamed: JP1.2, X1.9
unnamed: C15.1, IC7.5 (C2+)
unnamed: C14.1, IC7.7 (V-)
unnamed: C16.1, IC7.4 (C1-)
unnamed: C15.2, IC7.6 (C2-)
unnamed: C13.1, IC7.3 (V+)
unnamed: D1.1 (K), D2.1 (K), IC6.8 (VCC)
unnamed: D1.2 (A), G1.+
unnamed: C18.1, IC8.15 (XTAL1), Q3.1, R7.2
unnamed: IC8.14 (/RESET), R8.2
unnamed: IC8.7 (/IRQ), R6.1
RTS0: IC7.8 (T2OUT), X1.7
RXD0: IC7.14 (R1IN), X1.2
RXD_232: IC7.13 (R1OUT), IC8.13 (RX); also elsewhere on the board
SCL: IC6.6 (SCL), IC8.5 (SCL), IC9.14 (SCL); also elsewhere on the board
SDA: IC6.5 (SDA), IC8.6 (SDA), IC9.15 (SDA); also elsewhere on the board
TXD0: IC7.15 (T1OUT), X1.3
TXD_232: IC7.12 (T1IN), IC8.12 (TX); also elsewhere on the board

Notes on the sheet:
Adr. 0x50 (7 Bit)
RTC
NOTE: Crystal speed
baud rates between
UART
Adr. 0x48 (7 Bit)
allows for common
9600 and 921600.
GPIO
Adr. 0x20 (7 Bit) PCF8574
J.Grabow
V 1.2
I2C 3.3V - Bus
aeternum
RS-232
Shutdown Mode 4
Adr. 0x38 (7 Bit) PCF8574A

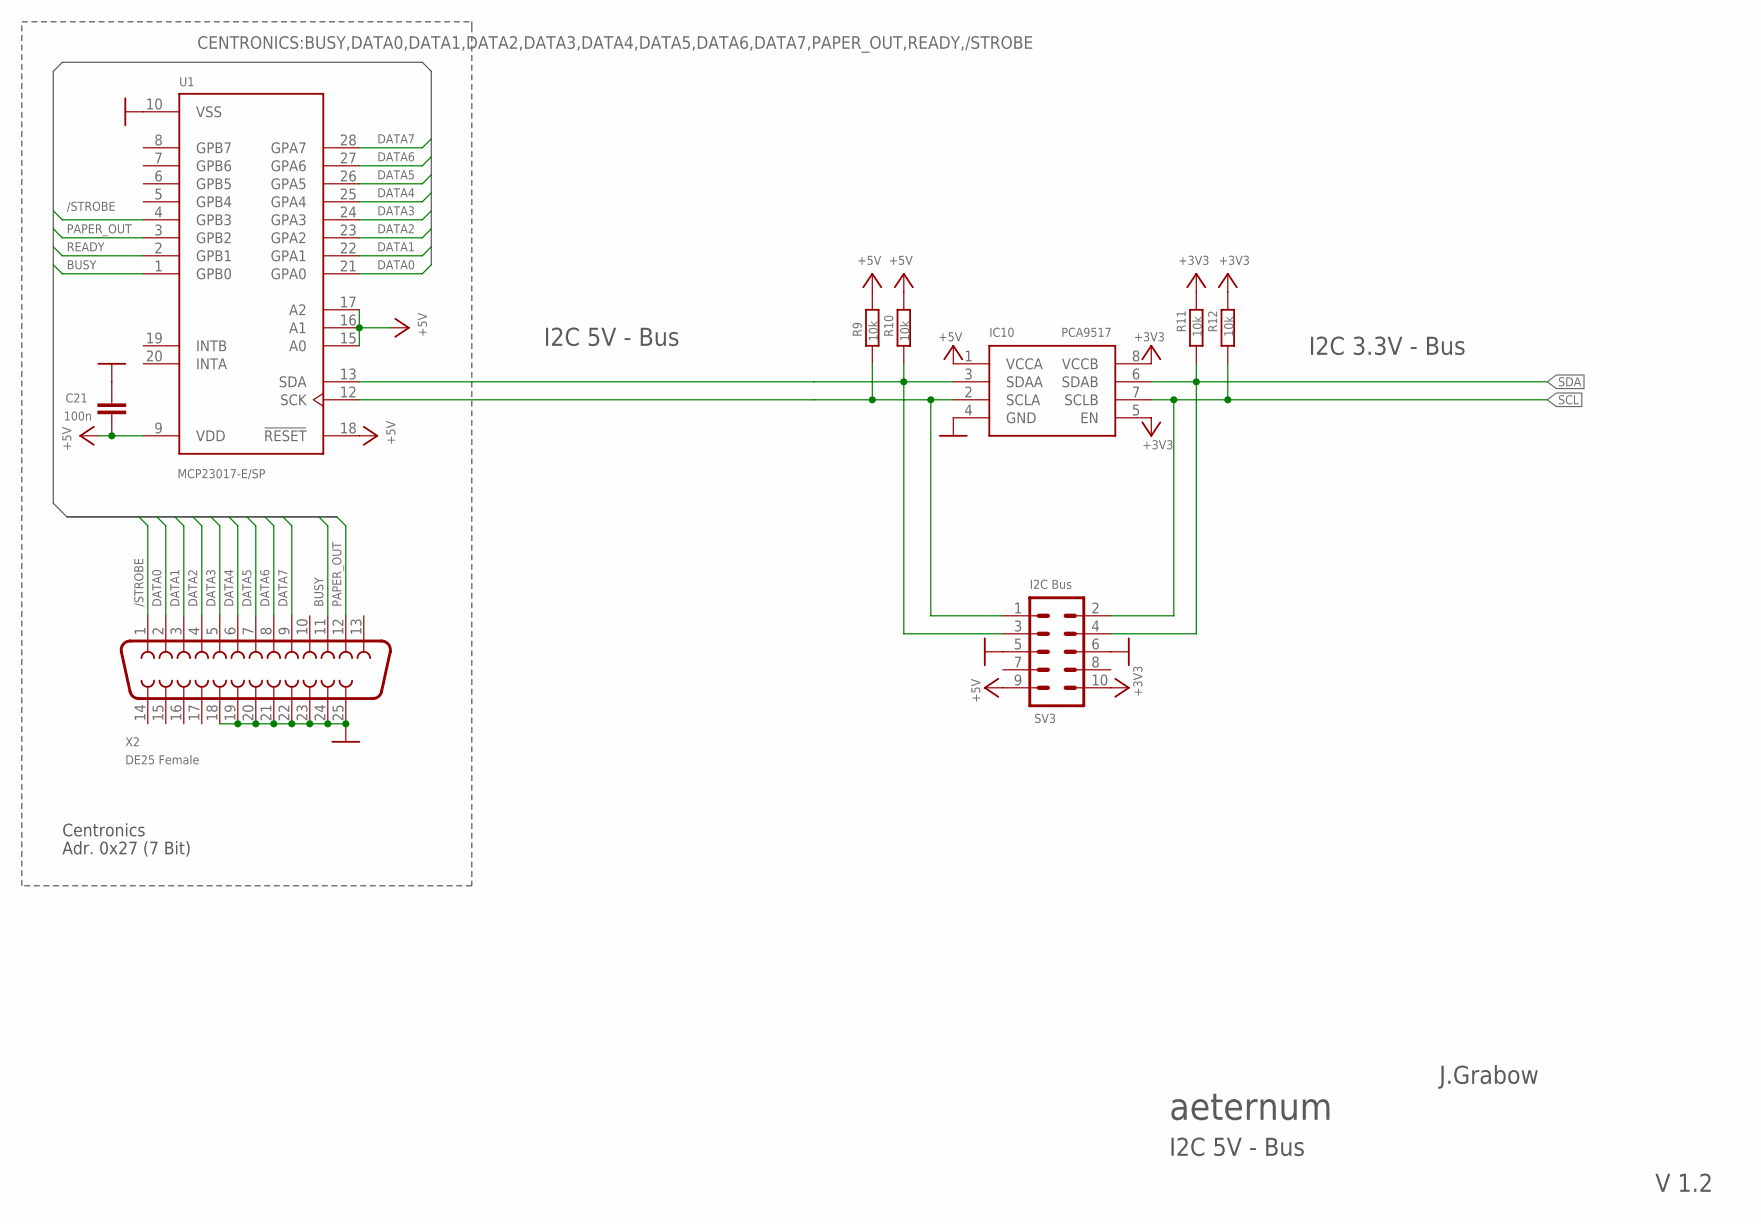
[picture p41: schematic Aeternum_V1_2.sch, sheet 3]

Parts:
C21: 100n; C025-024X044
IC10: PCA9517; SO-08
R9, R10, R11, R12: 10k; 0207/2V
SV3: I2C Bus; ML10L
U1: MCP23017-E/SP; DIP793W45P254L3556H508Q28
X2: DE25 Female; F25H

Connections:
+3V3: IC10.5 (EN), IC10.8 (VCCB), R11.2, R12.2, SV3.10; also elsewhere on the board
+5V: C21.1, IC10.1 (VCCA), R9.2, R10.2, SV3.9, U1.9 (VDD), U1.15 (A0), U1.16 (A1), U1.17 (A2), U1.18 (!RESET); also elsewhere on the board
/STROBE: U1.4 (GPB3), X2.1
BUSY: U1.1 (GPB0), X2.11
DATA0: U1.21 (GPA0), X2.2
DATA1: U1.22 (GPA1), X2.3
DATA2: U1.23 (GPA2), X2.4
DATA3: U1.24 (GPA3), X2.5
DATA4: U1.25 (GPA4), X2.6
DATA5: U1.26 (GPA5), X2.7
DATA6: U1.27 (GPA6), X2.8
DATA7: U1.28 (GPA7), X2.9
GND: C21.2, IC10.4 (GND), SV3.5, SV3.6, U1.10 (VSS), X2.18, X2.19, X2.20, X2.21, X2.22, X2.23, X2.24, X2.25; also elsewhere on the board
PAPER_OUT: U1.3 (GPB2), X2.12
READY: U1.2 (GPB1)
SCL: IC10.7 (SCLB), R12.1, SV3.2; also elsewhere on the board
SCLA: IC10.2 (SCLA), R9.1, SV3.1, U1.12 (SCK)
SDA: IC10.6 (SDAB), R11.1, SV3.4; also elsewhere on the board
SDAA: IC10.3 (SDAA), R10.1, SV3.3, U1.13 (SDA)

Notes on the sheet:
I2C 5V - Bus
aeternum
J.Grabow
V 1.2
I2C 3.3V - Bus
Adr. 0x27 (7 Bit)
Centronics

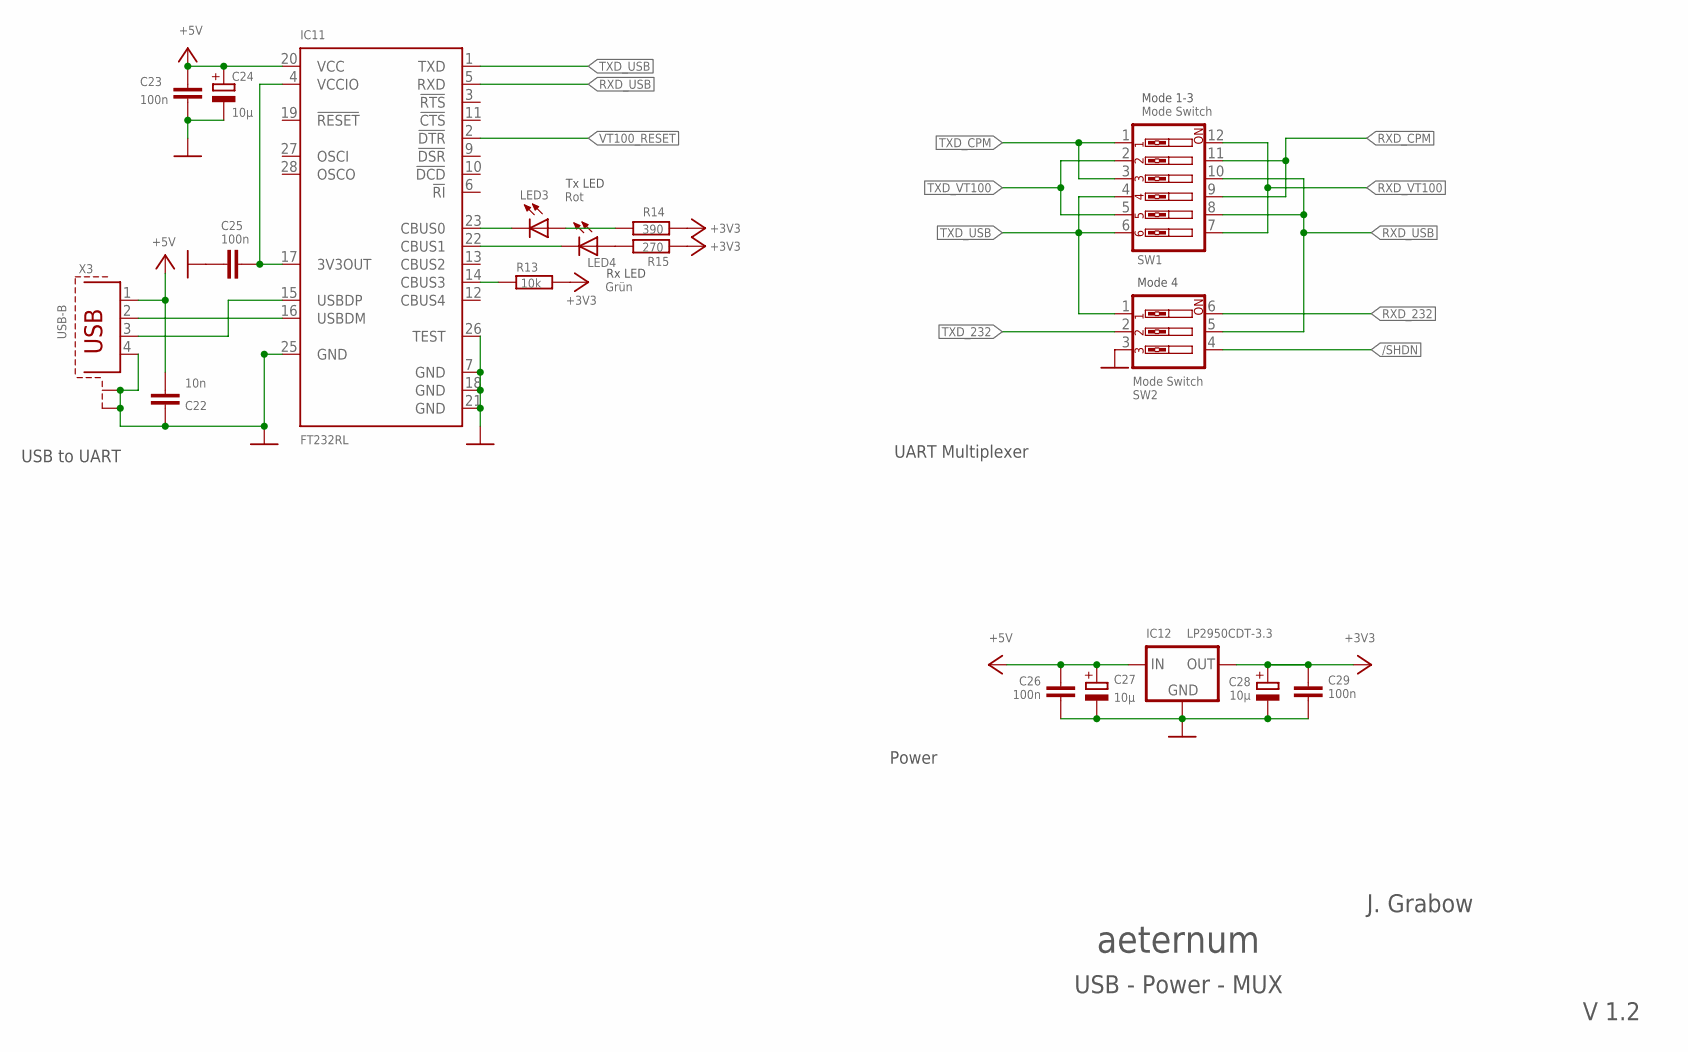
[picture p42: schematic Aeternum_V1_2.sch, sheet 4]

Parts:
C22: 10n; C025-024X044
C23, C25, C26, C29: 100n; C025-024X044
C24, C27, C28: 10µ; E2-5
IC11: FT232RL; SSOP28
IC12: LP2950CDT-3.3; DPACK
LED3: Rot; CHIPLED_0603
LED4: Grün; CHIPLED_0603
R13: 10k; 0204V
R14: 390; 0204V
R15: 270; 0204V
SW1: Mode Switch; EDG-06
SW2: Mode Switch; EDG-03
X3: USB-B; PN61729-S

Connections:
+3V3: C28.+, C29.2, IC12.3 (OUT), R13.2, R14.2, R15.2; also elsewhere on the board
+5V: C22.2, C23.2, C24.+, C26.2, C27.+, IC11.20 (VCC), IC12.1 (IN), X3.1; also elsewhere on the board
/SHDN: SW2.4; also elsewhere on the board
GND: C22.1, C23.1, C24.-, C25.1, C26.1, C27.-, C28.-, C29.1, IC11.7 (GND), IC11.18 (GND), IC11.21 (GND), IC11.25 (GND), IC11.26 (TEST), IC12.4 (GND), SW2.3, X3.4, X3.S1, X3.S2; also elsewhere on the board
unnamed: IC11.16 (USBDM), X3.2
unnamed: IC11.15 (USBDP), X3.3
unnamed: IC11.14 (CBUS3), R13.1
unnamed: C25.2, IC11.4 (VCCIO), IC11.17 (3V3OUT)
unnamed: IC11.23 (CBUS0), LED3.C
unnamed: IC11.22 (CBUS1), LED4.C
unnamed: LED4.A, R15.1
unnamed: LED3.A, R14.1
RXD_232: SW2.6; also elsewhere on the board
RXD_CPM: SW1.9, SW1.11; also elsewhere on the board
RXD_USB: IC11.5 (RXD), SW1.8, SW1.10, SW2.5
RXD_VT100: SW1.7, SW1.12; also elsewhere on the board
TXD_232: SW2.2; also elsewhere on the board
TXD_CPM: SW1.1, SW1.3; also elsewhere on the board
TXD_USB: IC11.1 (TXD), SW1.4, SW1.6, SW2.1
TXD_VT100: SW1.2, SW1.5; also elsewhere on the board
VT100_RESET: IC11.2 (!DTR); also elsewhere on the board

Notes on the sheet:
Mode 1-3
Mode 4
USB to UART
UART Multiplexer
Power
USB - Power - MUX
aeternum
J. Grabow
V 1.2
Tx LED
Rx LED

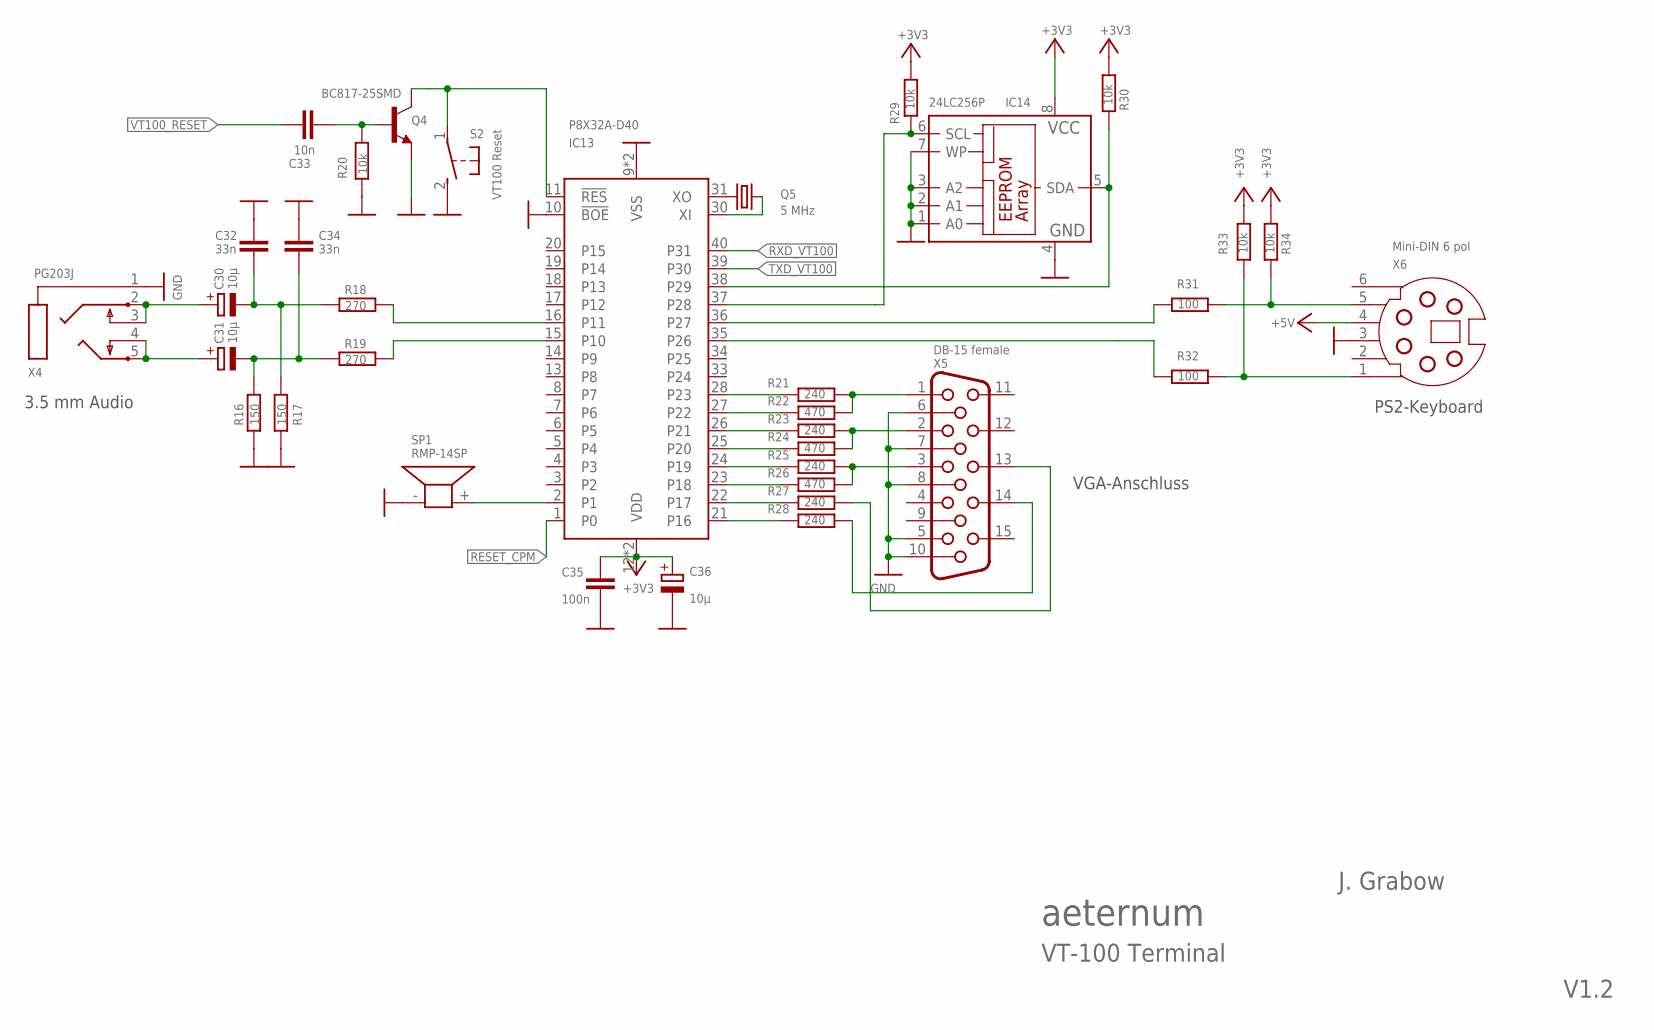
[picture p43: schematic Aeternum_V1_2.sch, sheet 5]

Parts:
C30, C31: 10µ; E2,5-5
C32, C34: 33n; C025-024X044
C33: 10n; C025-024X044
C35: 100n; C025-024X044
C36: 10µ; E2,5-6E
IC13: P8X32A-D40; DIL40
IC14: 24LC256P; DIL8
Q4: BC817-25SMD; SOT23-BEC
Q5: 5 MHz; HC49/S
R16, R17: 150; 0204V
R18, R19: 270; 0204V
R20, R33, R34: 10k; 0204V
R21, R23, R25, R27, R28: 240; 0204V
R22, R24, R26: 470; 0204V
R29, R30: 10k; 0204/7
R31, R32: 100; 0204V
S2: VT100 Reset; B3F-31XX
SP1: RMP-14SP; KSS1201
X4: PG203J
X5: DB-15 female; HDF15H
X6: Mini-DIN 6 pol; SSV-BC06

Connections:
+3V3: C35.2, C36.+, IC13.12 (VDD), IC13.32 (VDD), IC14.8 (VCC), R29.1, R30.1, R33.1, R34.1; also elsewhere on the board
+5V: X6.4; also elsewhere on the board
GND: C32.2, C34.2, C35.1, C36.-, IC13.9 (VSS), IC13.10 (!BOE), IC13.29 (VSS), IC14.1 (A0), IC14.2 (A1), IC14.3 (A2), IC14.4 (GND), IC14.7 (WP), Q4.E, R16.2, R17.2, R20.1, S2.2 (S), SP1.- (2), X4.1, X5.5, X5.6, X5.7, X5.8, X5.10, X6.3; also elsewhere on the board
unnamed: IC13.30 (XI), Q5.1
unnamed: R21.1, R22.1, X5.1
unnamed: IC13.28 (P23), R21.2
unnamed: IC13.27 (P22), R22.2
unnamed: R23.1, R24.1, X5.2
unnamed: IC13.26 (P21), R23.2
unnamed: IC13.25 (P20), R24.2
unnamed: R25.1, R26.1, X5.3
unnamed: IC13.24 (P19), R25.2
unnamed: IC13.23 (P18), R26.2
unnamed: IC13.22 (P17), R27.2
unnamed: IC13.21 (P16), R28.2
unnamed: R27.1, X5.13
unnamed: R28.1, X5.14
unnamed: R32.1, R33.2, X6.1
unnamed: R31.1, R34.2, X6.5
unnamed: IC13.31 (XO), Q5.2
unnamed: IC13.2 (P1), SP1.+ (1)
unnamed: C33.2, Q4.B, R20.2
unnamed: IC13.37 (P28), IC14.6 (SCL), R29.2
unnamed: IC13.38 (P29), IC14.5 (SDA), R30.2
unnamed: C31.-, C34.1, R16.1, R19.2
unnamed: C30.-, C32.1, R17.1, R18.2
unnamed: C30.+, X4.2, X4.3
unnamed: C31.+, X4.4, X4.5
P10: IC13.16 (P11), R18.1
P11: IC13.15 (P10), R19.1
P26: IC13.35 (P26), R32.2
P27: IC13.36 (P27), R31.2
PROP_RESET: IC13.11 (!RES), Q4.C, S2.1
RESET_CPM: IC13.1 (P0); also elsewhere on the board
RXD_VT100: IC13.40 (P31); also elsewhere on the board
TXD_VT100: IC13.39 (P30); also elsewhere on the board
VT100_RESET: C33.1; also elsewhere on the board

Notes on the sheet:
aeternum
J. Grabow
VT-100 Terminal
V1.2
PS2-Keyboard
VGA-Anschluss
3.5 mm Audio

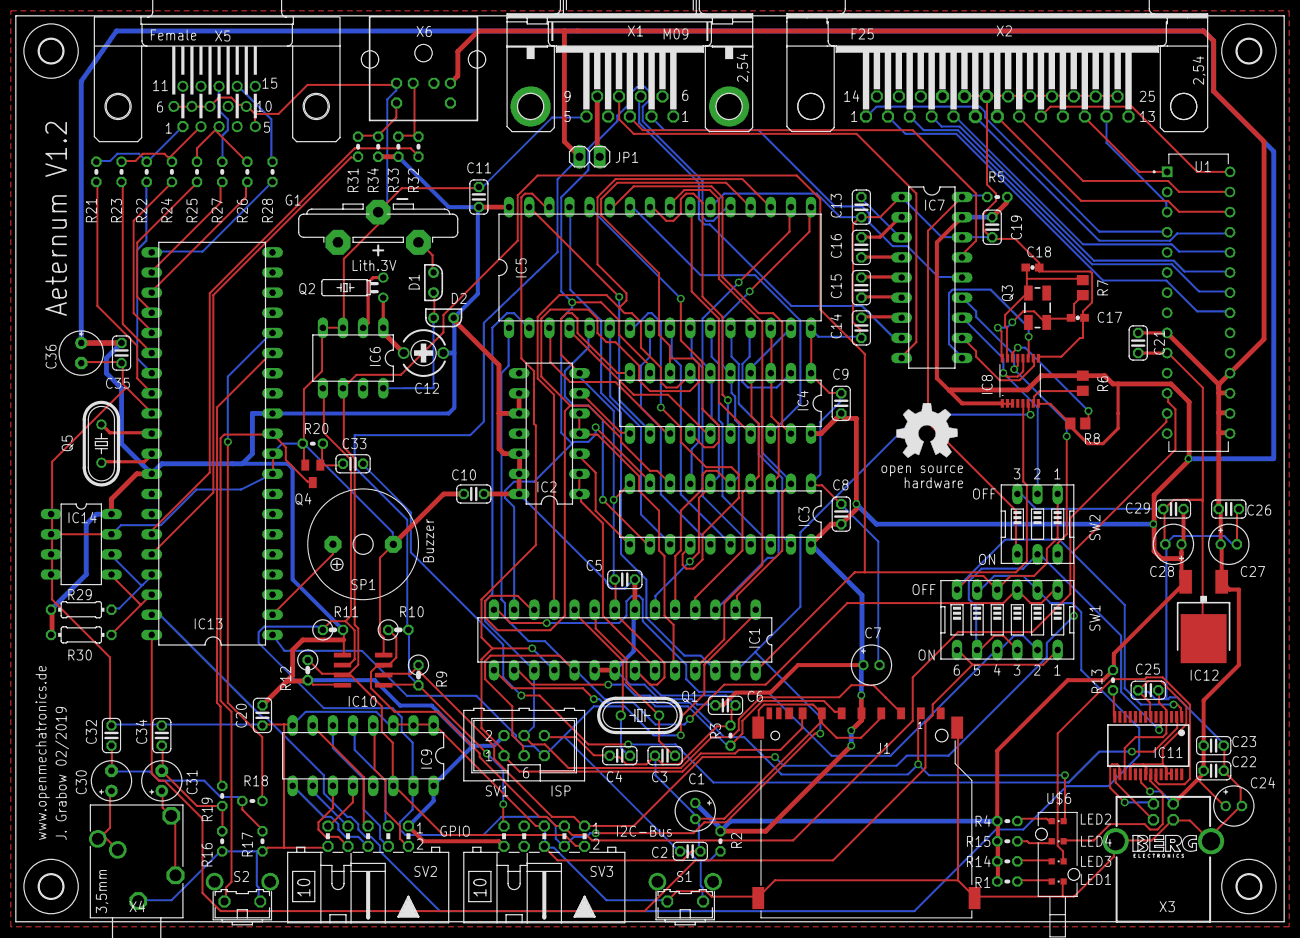
[picture p44: board Aeternum_V1_2.brd from above]

Board: 2 copper layers, 160.0 x 114.3 mm, 119 parts (0 on the bottom side), 134 nets.

Other parts of the board:
U$1, U$2, U$3, U$4: 3,0
U$6: OPTO_THT_LWL_MENTOR_1296_1004
U$7: OSHW_8MM
