Feinmechaniker/AVRCPM/(commit log)

2019-02-21 AVR Code
    [avrcpm.obj]
2019-03-06 CP/M Modem Tools
    [XMODEM.CFG]
2019-03-07 Sheet & PCB
2019-03-07 EAGLE data
    [Aeternum_V1_0.brd, Aeternum_V1_0.sch, Aeternum_V1_2.brd, Aeternum_V1_2.sch]
2019-03-07 case part 1
    [Oben.dxf, Unten.dxf]
2019-03-07 case part 2
    [Hinten.dxf]
2019-03-07 picture of case
2019-03-08 added connectors
2019-03-15 new diameter for keybord connector
    [Hinten.dxf]
2019-08-01 AVR Project for Atmel Studio 7
    [avrcpm.obj]
